openvizsla/ov_ftdi/(threads)

Thread 4 (2015-11-06):

Error in building ov_ftdi

jeffreyantony, 2015-11-06:
I tried to build ov_ftdi. I gave a 'make' in the folder 'ov_ftdi/software/fpga/ov3' and got the below error

Could you let me know how can I remove the below error? I am not sure if I  have an updated 'NetowrkX'.

Is it possible for you to update to the new Migen ?

$ make
python3 build.py build_dir build build_name ov3
Traceback (most recent call last):
  File "build.py", line 24, in <module>
    top = OV3(plat)
  File "/home/robo/tools/ov_ftdi/software/fpga/ov3/ovhw/top.py", line 119, in __init__
    [self.randtest, self.sdram_host_read])
  File "/home/robo/tools/ov_ftdi/software/fpga/ov3/ovhw/cmdproc.py", line 37, in __init__
    self.submodules.fg = CompositeActor(g)
  File "/home/robo/tools/ov_ftdi/software/fpga/migen/migen/flow/network.py", line 222, in __init__
    dfg.elaborate()
  File "/home/robo/tools/ov_ftdi/software/fpga/migen/migen/flow/network.py", line 215, in elaborate
    self._eliminate_subrecords_and_divergences()
  File "/home/robo/tools/ov_ftdi/software/fpga/migen/migen/flow/network.py", line 129, in _eliminate_subrecords_and_divergences
    for (dst_node, dst_endpoint), sources in self._sink_to_sources().items():
  File "/home/robo/tools/ov_ftdi/software/fpga/migen/migen/flow/network.py", line 101, in _sink_to_sources
    for u, v, data in self.edges_iter(data=True):
AttributeError: 'DataFlowGraph' object has no attribute 'edges_iter'
Makefile:18: recipe for target 'build/ov3.bit' failed
make: *** [build/ov3.bit] Error 1

Goddard, 2016-03-17:
I think the main maintainer passed away.  If anything is going to happen it is gonna have to be us.

Thread 6 (2017-10-17):

I'm ordering PCB any one interested?

kopasiak, 2017-10-17:
Hi,

Together with my colleagues we are planing to build couple of OpenVizsla for us. Any one interested in ordering PCBs together or getting a mounted device?

Leave message in this thread or drop me an email at kopasiak90+openvizsla (<stop spam> at) gmail.com

Goddard, 2018-03-10:
I know this is probably kind of late, but still doing it?

wxh0000mm, 2018-11-27:
I plan to make PCB by myself, buy chips for soldering and DIY.

Thread 8 (2018-03-03):

Where's the license?

micolous, 2018-03-03:
Looking over this repository, I cannot find any license for the software.  Please add one!

https://choosealicense.com/no-permission/

Goddard, 2018-03-10:
The guy that made this hardware and software passed away.

micolous, 2018-03-11:
Hmm... this is difficult then.

I happened to borrow some of this hardware to debug some USB issues I'm having.  I'm trying to "finish" the Wireshark module. There's some code in sigrok that implements a state machine that allows transforming USB link-layer into the same sort of USB captures that you get out of Linux usbmon. That would be good enough.

However, in order to incorporate the two together would violate the license of sigrok -- as that is GPL, and OV is "???".

The only way I see around that is to entirely reimplement the host software side of things.  This is difficult for me as there is also little documentation about how the host-device communication works. I don't feel comfortable working from the existing source release when the license is undefined.

Even if I find some other documentation here that would point to a license from the original author, there are also other contributors to the project, and _their_ intent is also unclear.

I could write something up that solves my problems, but I would not be able to release it.

I'm just mindful of getting into too much yak shaving. ;)

Goddard, 2018-03-11:
Well the designs of the hardware are under creative commons.  As for the code, most people deal with instances like that by just having an automated downloader and if a third-party provides the binaries you can even auto-download those and the user clicks the button which results in no infringement on a license.

somehdlguy, 2018-03-11:
Hey all, re license. Everything I wrote (parts of the host python, comms and the FPGA HDL) may be considered to be under 2-clause BSD. I'm speaking with some of the others that wrote large chunks of code (tmbinc, marcan et al) and we'll agree on a license and put a license statement up.

It'll be something open source, just not sure on exactly which one we'll end up with. (probably GPL-2-or-later, or BSD would be my guess)

somehdlguy, 2018-03-11:
Also, I can talk about

tmbinc, 2018-03-11:
For what I wrote:

 - Wireshark plugin is probably derived work, so it'll be GPLv2. I'll add a LICENSE immediately.
 - For any HDL code that I wrote I'm fine with 2-clause BSD. Once we agreed, we'll put a LICENSE file there.

somehdlguy, 2018-03-11:
I spoke to marcan, he's OK with 2-clause BSD for everything he touched. You wrote / extended a bunch of the host side python code as well (I assume you are OK with 2-clause BSD on that?).

In any case, between the 3 of us, we wrote the vast majority of the host-side and device side code. Ben mostly contributed bugfixes to the host-side code, his primary responsibility was the hardware (which as is noted above, he marked CC-BY-SA).

I think we are good to go with 2-clause BSD then, with an exception for the wireshark derived code which would be GPLv2.

tmbinc, 2018-03-11:
Sounds good!

micolous, 2018-03-13:
Thanks for clearing this up!

Closed 2018-03-11.

Thread 9 (2018-05-12):

Hardware for project

tbutton, 2018-05-12:
All versions of Openvizsla out of stock. Could you help please suggest another board for this project. Thank you!

laf0rge, 2018-06-07:
I'm not in the US but would be interested in buying any of the "old" OpenViszla boards.  In fact, I'm even interested in building some more, as needed (I regularly design + build all kinds of electronics).

The big question to me is what happened to the project, given the huge kickstarter success 4 years ago, and the statement from @tmbinc that hardware/gateware is "done".  As a regular wireshark contributor, I'm not so worried about having to improve the visualization side on the host.  Also, these days sigrok has USB trace decoding/displaying capabilities, too.

laf0rge, 2018-06-07:
thanks for your feedback.  I think I would be interested in playing with one of the units for some time in order to see if and how to move it ahead.  Making the hardware available is not a problem for me, we already make available several circuit boards from the @osmocom community and distribute it over the sysmocom webshop, such as the Osmcoom SIMtrace, which is a protocol tracer for SIM cards (or actually any smart cards).

Please note that I'm not primarily interested in *selling* something, but simply in enabling anyone to easily get their hands on a related board if they'd like to play with it.

To me, this project looks a bit like a "hidden gem".  A lot of work was done years ago, several people claim that the it's fundamentally working.  There doesn't appear to be any FOSS / OpenHardware alternative, and for many use cases sniffing FS/HS USB is also still more than sufficient.

It would be great if I could somehow get my hands on a "known working" board first to avoid having to spend time on building a board from scratch and doign board-bringup, testing, etc. on a device that I'm not familiar with yet...

somehdlguy, 2018-06-07:
@laf0rge: I'll follow up with you directly via email or IRC regarding availability of a board for development purposes.

Separately, I'll see whether the tree still builds with current versions of dependencies, and if necessary, fix the build.

cyphunk, 2018-08-20:
@laf0rge I have one from the original kickstarted I'd happily loan you. I know it worked a few years ago.

laf0rge, 2021-05-31:
In case it hasn't been noticed meanwhile, there are two sources for OpenVizsla that have appeared manwhile, see the links in the README.md at https://github.com/openvizsla/ov_ftdi#obtaining-hardware

Closed 2021-05-31.

Thread 10 (2018-07-06):

Migrate FPGA firmware to the latest Migen

matwey, 2018-07-06:
Well, if somebody have a branch with support of the latest Migen, please put a note here.

somehdlguy, 2018-07-06:
I have an in-progress port to the latest migen. It currently generates a bitstream that isn't fully tested yet, and I still need to fix some of the sim tests. I should be able to finish testing it in the next few days at which point  I'll push the branch.

matwey, 2018-07-06:
@somehdlguy really nice to hear that. Do you have write access to this repo?

somehdlguy, 2018-07-06:
I do, and I'll push it here once I have it tested. I'll close this issue at that time so you get a notification.

matwey, 2018-07-06:
Thank you very much.

matwey, 2018-08-04:
What do I do wrong? I use migen and misoc from master.

```
> make
python3 build.py build_dir build build_name ov3
. /opt/Xilinx/14.7/ISE_DS/common/.settings64.sh /opt/Xilinx/14.7/ISE_DS/common
. /opt/Xilinx/14.7/ISE_DS/EDK/.settings64.sh /opt/Xilinx/14.7/ISE_DS/EDK
. /opt/Xilinx/14.7/ISE_DS/PlanAhead/.settings64.sh /opt/Xilinx/14.7/ISE_DS/PlanAhead
. /opt/Xilinx/14.7/ISE_DS/ISE/.settings64.sh /opt/Xilinx/14.7/ISE_DS/ISE
Release 14.7 - xst P.20131013 (lin64)
Copyright (c) 1995-2013 Xilinx, Inc.  All rights reserved.
-->
WARNING:Xst:1583 - You are using an internal switch '-use_new_parser'.

TABLE OF CONTENTS
  1) Synthesis Options Summary
  2) HDL Parsing
  3) HDL Elaboration
  4) HDL Synthesis
       4.1) HDL Synthesis Report
  5) Advanced HDL Synthesis
       5.1) Advanced HDL Synthesis Report
  6) Low Level Synthesis
  7) Partition Report
  8) Design Summary
       8.1) Primitive and Black Box Usage
       8.2) Device utilization summary
       8.3) Partition Resource Summary
       8.4) Timing Report
            8.4.1) Clock Information
            8.4.2) Asynchronous Control Signals Information
            8.4.3) Timing Summary
            8.4.4) Timing Details
            8.4.5) Cross Clock Domains Report

=========================================================================
*                      Synthesis Options Summary                        *
=========================================================================
---- Source Parameters
Input File Name                    : "top.prj"
Input Format                       : MIXED

---- Target Parameters
Output File Name                   : "top.ngc"
Target Device                      : xc6slx9-tqg144-3

---- Source Options
Top Module Name                    : top
Use New Parser                     : yes
Automatic Register Balancing       : yes

---- General Options
Optimization Goal                  : SPEED

=========================================================================

WARNING:Xst:29 - Optimization Effort not specified
=========================================================================

=========================================================================
*                          HDL Parsing                                  *
=========================================================================
Analyzing Verilog file "/home/matwey/lab/ov_ftdi/software/fpga/ov3/build/top.v" into library work
Parsing module <top>.
ERROR:HDLCompiler:1660 - "/home/matwey/lab/ov_ftdi/software/fpga/ov3/build/top.v" Line 4518: Procedural assignment to a non-register overflowinserter_re is not permitted, left-hand side should be reg/integer/time/genvar
ERROR:HDLCompiler:1660 - "/home/matwey/lab/ov_ftdi/software/fpga/ov3/build/top.v" Line 4518: Procedural assignment to a non-register overflowinserter_re is not permitted, left-hand side should be reg/integer/time/genvar
ERROR:HDLCompiler:1660 - "/home/matwey/lab/ov_ftdi/software/fpga/ov3/build/top.v" Line 4881: Procedural assignment to a non-register sdram_sink_ptr_read_re is not permitted, left-hand side should be reg/integer/time/genvar
ERROR:HDLCompiler:1660 - "/home/matwey/lab/ov_ftdi/software/fpga/ov3/build/top.v" Line 4881: Procedural assignment to a non-register sdram_sink_ptr_read_re is not permitted, left-hand side should be reg/integer/time/genvar
ERROR:HDLCompiler:1660 - "/home/matwey/lab/ov_ftdi/software/fpga/ov3/build/top.v" Line 4921: Procedural assignment to a non-register sdram_sink_debug_ctl_re is not permitted, left-hand side should be reg/integer/time/genvar
ERROR:HDLCompiler:1660 - "/home/matwey/lab/ov_ftdi/software/fpga/ov3/build/top.v" Line 4921: Procedural assignment to a non-register sdram_sink_debug_ctl_re is not permitted, left-hand side should be reg/integer/time/genvar
ERROR:HDLCompiler:1660 - "/home/matwey/lab/ov_ftdi/software/fpga/ov3/build/top.v" Line 5063: Procedural assignment to a non-register sdram_sink_ptr_read_re is not permitted, left-hand side should be reg/integer/time/genvar
ERROR:HDLCompiler:1660 - "/home/matwey/lab/ov_ftdi/software/fpga/ov3/build/top.v" Line 5063: Procedural assignment to a non-register sdram_sink_ptr_read_re is not permitted, left-hand side should be reg/integer/time/genvar
ERROR:HDLCompiler:1660 - "/home/matwey/lab/ov_ftdi/software/fpga/ov3/build/top.v" Line 5076: Procedural assignment to a non-register sdram_sink_debug_ctl_re is not permitted, left-hand side should be reg/integer/time/genvar
ERROR:HDLCompiler:1660 - "/home/matwey/lab/ov_ftdi/software/fpga/ov3/build/top.v" Line 5076: Procedural assignment to a non-register sdram_sink_debug_ctl_re is not permitted, left-hand side should be reg/integer/time/genvar
ERROR:HDLCompiler:1660 - "/home/matwey/lab/ov_ftdi/software/fpga/ov3/build/top.v" Line 5107: Procedural assignment to a non-register overflowinserter_re is not permitted, left-hand side should be reg/integer/time/genvar
ERROR:HDLCompiler:1660 - "/home/matwey/lab/ov_ftdi/software/fpga/ov3/build/top.v" Line 5107: Procedural assignment to a non-register overflowinserter_re is not permitted, left-hand side should be reg/integer/time/genvar
ERROR:HDLCompiler:1660 - "/home/matwey/lab/ov_ftdi/software/fpga/ov3/build/top.v" Line 5232: Procedural assignment to a non-register data_out_source_stb is not permitted, left-hand side should be reg/integer/time/genvar
ERROR:HDLCompiler:1660 - "/home/matwey/lab/ov_ftdi/software/fpga/ov3/build/top.v" Line 5232: Procedural assignment to a non-register data_out_source_stb is not permitted, left-hand side should be reg/integer/time/genvar
ERROR:HDLCompiler:1660 - "/home/matwey/lab/ov_ftdi/software/fpga/ov3/build/top.v" Line 5234: Procedural assignment to a non-register data_out_source_payload_d is not permitted, left-hand side should be reg/integer/time/genvar
ERROR:HDLCompiler:1660 - "/home/matwey/lab/ov_ftdi/software/fpga/ov3/build/top.v" Line 5234: Procedural assignment to a non-register data_out_source_payload_d is not permitted, left-hand side should be reg/integer/time/genvar
ERROR:HDLCompiler:1660 - "/home/matwey/lab/ov_ftdi/software/fpga/ov3/build/top.v" Line 5235: Procedural assignment to a non-register data_out_source_payload_rxcmd is not permitted, left-hand side should be reg/integer/time/genvar
ERROR:HDLCompiler:1660 - "/home/matwey/lab/ov_ftdi/software/fpga/ov3/build/top.v" Line 5235: Procedural assignment to a non-register data_out_source_payload_rxcmd is not permitted, left-hand side should be reg/integer/time/genvar
ERROR:HDLCompiler:1660 - "/home/matwey/lab/ov_ftdi/software/fpga/ov3/build/top.v" Line 5239: Procedural assignment to a non-register data_out_source_payload_d is not permitted, left-hand side should be reg/integer/time/genvar
Sorry, too many errors..
-->
```

matwey, 2018-08-04:
There is no branch `new_migen` in `tmbinc/ov_ftdi`. I've tried `new_migen` from `openvizsla/ov_ftdi`.

matwey, 2018-08-04:
I am sorry, I've found correct branch. Thank you.

Thread 11 (2018-07-11):

Licensing and selling

matwiszynmarek, 2018-07-11:
Good morning,
I have been doing a research about this type of products and I have got a few questions.
1. What are the certifications for this product (I mean EMC, RCC, CE etc.)?
2. What is the license for software and hardware?
3. Is it possible to sell OpenVizsla made by my own production?

I'll be very thankful if you respond me.

Yours sincerely
Marek

somehdlguy, 2018-07-28:
1. There are no certs that we are aware of. Any certs that were acquired as part of the kickstarter run are unknown to us (and bushing, who would have known, passed away).
Before you sell anything, you'll need to figure out what certs are required for the jurisdictions you plan to sell to, then acquire said certs.
2. The license varies depending on what part of the repo. Some files are under CC-like terms, some under GPL, some under BSD. Check the license files in the repo.
3. Sure, why not. Just follow the licenses and release any modifications as is required. (though, we'd appreciate patches for the parts of the code under BSD).

I'd suggest that if you are going to production, you consider updating to a newer FPGA, and review the BOM for EOL components. Of course, you would then need to re-debug and requalify the design.

Closed 2018-07-28.

Thread 13 (2018-08-05):

SDRAM data trapping

matwey, 2018-08-05:
I am working on pure-C implementation for OpenVizsla host software: https://github.com/matwey/libopenvizsla
I've faced the following issue with FPGA firmware last summer.
I have been not able to make FPGA reliable restart sniffed data transmission.

The issue itself is the following.
The protocol has two encapsulation levels.
The upper level is packets come from SDRAM buffering module.
The packets consists of `0x0D` magic header, `length` byte, and the `data`.
On practice this packets are of the same length.
The nested data is a stream consisted of packets from captured data.
They are consisted of `0xA0` magic header, `length` and USB `data`.
This packets are not aligned with each other.
One `0x0D`-packet may consisted many `0xA0`-packets, and `0xA0`-packet may be split between two consecutive `0x0D`-packets.

When I stop capturing and streaming and start it again then the first data byte of the first `0x0D`-packet is not `0xA0` which it should be.
This is an issue because there is no other reliable way to sync `0xA0`-packet stream. We cannot just scan for first `0xA0` because `0xA0` byte may be consisted inside `data` itself (compare with SLIP protocol).

My stop sequence is the following:

 * write `0` to `SDRAM_HOST_READ_GO` (`0xC28`)

 * write `0` to `SDRAM_SINK_GO` (`0xE11`)

 * write `0` to `CSTREAM_CFG` (`0x800`)

My start sequence is the following (given I assured that the stream is stopped):

 * write 32-bit `0` to `SDRAM_SINK_RING_BASE` (`0xE09`)

 * write 32-bit `0x01000000` to `SDRAM_SINK_RING_END` (`0xE0D`)

 * write 32-bit `0` to `SDRAM_HOST_READ_RING_BASE` (`0xC1C`)

 * write 32-bit `0x01000000` to `SDRAM_HOST_READ_RING_END` (`0xC20`)

 * write `0` to `SDRAM_SINK_PTR_READ` (`0xE00`)

 * write `1` to `CSTREAM_CFG` (`0x800`)

 * write `1` to `SDRAM_SINK_GO` (`0xE11`)

 * write `1` to `SDRAM_HOST_READ_GO` (`0xC28`)

I've tried to add `Reset` for `sdram_fifo` in `SDRAM_Sink` and `SDRAM_Host_Read` to reset fifoes on `SDRAM_SINK_GO`/`SDRAM_HOST_READ_GO` switch but this didn't help.

tmbinc, 2018-08-05:
First, remember how the SDRAM buffering works: There's the SDRAM_SINK
which sinks 8-bit data from the cstream (aka "Whacker"), and writes it
into SDRAM.

Then there's the SRAM_Host_Read, which reads data from SDRAM, packetizes
it to host_burst_length (=16 * 2bytes), and sends those over the
"CmdProc", aka. the thing that muxes together the different data sources
for the return (FTDI) channel.

SDRAM_Sink and SDRAM_Host_Read know each other's read/write pointers so
that we have flow control.

cstream (whacker's producer) receives data from ULPI (timestamp'ed
d/is_start/is_end/is_err/isovr) and formats it into the A0 <flags>
<size> <data> (which SDRAM_Sink writes into memory).

That means that once these packets arrive in SDRAM, there's no packet
boundary anymore; SDRAM_Host_Read doesn't care what the data is, it only
knows about the write pointer and will stream everything to that point.

Now, note that SDRAM_Sink will write partial packets, but at a 2 byte
granularity. However they will be collected on the input side, so no
data should be lost if you toggle GO, _assuming_ you still read out any
data.

sdram_host_sink on the other hand only sends full-sized packets to the
host (as you observed). The current rptr resets if you toggle go, and at
that point you almost certainly lost data.

So I'd think (but I haven't verified) that the correct way to pause
transfers would be the opposite order:

1. Disable streaming via CSTREAM_CFG. This halts receiving incoming ULPI
data, but should write out the rest of the current A0... packet.

2. Disable writing data to SDRAM via SDRAM_SINK_GO.

Once you read all data, you can do this:

3. Disable streaming data from SDRAM to HOST.

However note that there's currently no "flush" action - the last packet
will most likely not fully align to the 32 byte burst size so you'll
miss the last packet. Additionally one byte could be stuck in the
SDRAM_SINK that you can't un-stuck. (Perhaps it would be wise to make
the packets always even-length size...)

I'm not fully clear on your motivation to stop streaming, but if it's
just to ignore USB data for a while, to avoid the issue with the last
packet, I'd propose that you instead keep the SDRAM data streaming
enabled, and only pause using CSTREAM (i.e. only clear CSTREAM_CFG[0],
nothing else). You may still get a partial CSTREAM packet, but you would
get the rest of the packet when you re-enable it (and you could then
drop it).

For starting, I would also advise to turn the data flow on first
(SDRAM_HOST_Read+SDRAM_Sink, then CSTREAM) because otherwise you may get
an overflow in CSTREAM if you're not fast enough in this sequence.

In summary, I think the following additions would be "nice to have" :

1. CSTREAM should only produce even-length packets.
2. CSTREAM should indicate when it's done writing the last packet.
2a. CSTREAM could write a special pattern that indicates it was asked to
stop.
3. SDRAM_Sink should indicate when a single byte is stuck when ~go
(though this "shouldn't happen")
4. SDRAM_Host_Read should send a partial packet when go is deasserted,
and not wait for the full burst.
5. SDRAM_Host_Read should indicate when it is done sending all data.
6. We should have a global reset (as opposed to "go"); the intention
would be that deasserting "go" doesn't lose data (unless there's a fifo
overrun), but asserting "reset" would.

Felix

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

matwey, 2018-08-19:
Hello,

The motivation is simple. Any application can crash unexpectedly, so we cannot guarantee graceful exit. So the most reliable on-start behavior for us is to force stop streaming, and reinit all the things as they expected to be (full reset), and the start streaming from the scratch.

I've followed your advice and reordered starting procedure, but there is still no success. Even `CSTREAM` and `SINK` are OFF (and `SDRAM` pointers are reset to `0`), then the unexpected data are transmitted to host after I trigger `SDRAM_HOST_READ`.

Could you please also review the following:
https://github.com/matwey/ov_ftdi/commit/0ffe58f453fe70e08786f64027f241f3a6c0c96c
Does it makes sense?

matwey, 2018-08-19:
The most reliable setup is the following:
```
        // dev.regs.SDRAM_SINK_GO.wr(1)
        // dev.regs.SDRAM_HOST_READ_GO.wr(1)
        // dev.regs.CSTREAM_CFG.wr(1)
```
Using https://github.com/matwey/ov_ftdi/commit/0ffe58f453fe70e08786f64027f241f3a6c0c96c

matwey, 2018-08-19:
I still see that there is extra byte between `d0` and `a0`:

```
        0x0000:  3260 d01f 27a0 1000 0000 7df6 69a0 0000
        0x0010:  0300 3d43 7169 8498 a000 0001 00a5 4971
        0x0020:  5aa0 0000 0300 6596 7869 8498 a000 0001
        0x0030:  00cd 9c78 5aa0 0000 0300 8de9 7f69 8498
        0x0040:  a000 0001
```

Here `1f` is size byte, and then `a0` should follows in theory.

matwey, 2018-08-19:
Now I see that `self.fifo_fsm` from `SDRAM_sink` needs to be force reset to `READ_LOW` at every sink restart. Otherwise, it may cache the last odd byte from previous run.

somehdlguy, 2018-08-19:
Patches to fix this kind of thing are welcome! (I haven't been able to find my board to do anything that requires HW-in-the-loop testing).

Thread 17 (2018-09-11):

Output information from OV

ar0mat, 2018-09-11:
Hello everyone. I've been testing an OpenVizsla v3.2 device and I have a couple of problems. I'm trying to analyze a pendrive [https://stat-s9.ms-online.pl/media/cache/gallery/rc/b5o50r65/bdk/78/786367_0.jpg](url) and USB-UART converter.

I'm using software from the `master` branch. All of the tests are ok so the board is assembled correctly (I think)

But when I do sniffing, I receive such information, but nothing stems from it.

```
[        ]  60.145390 d=  0.000003 [ 69.4 + 89.817] [  3] IN   : 12.1
[        ]  60.145393 d=  0.000003 [ 69.4 + 92.467] [  3] IN   : 12.1
[        ]  60.145395 d=  0.000003 [ 69.4 + 95.117] [  3] IN   : 12.1
[        ]  60.145405 d=  0.000009 [ 69.4 +104.483] [  1] ACK
[        ]  60.145405 d=  0.000000 [ 69.4 +104.967] [  3] IN   : 12.1
[        ]  60.145408 d=  0.000003 [ 69.4 +107.617] [  3] IN   : 12.1
[        ]  60.145410 d=  0.000003 [ 69.4 +110.267] [  3] IN   : 12.1
[        ]  60.145426 d=  0.000015 [ 69.5 +  0.583] [  3] IN   : 12.1
[        ]  60.145431 d=  0.000005 [ 69.5 +  5.900] [  3] IN   : 12.1
[        ]  60.145434 d=  0.000003 [ 69.5 +  8.550] [  3] IN   : 12.1
[        ]  60.145436 d=  0.000003 [ 69.5 + 11.200] [  3] IN   : 12.1
```
I expected the output to be like in the manual for `HS sniffing` for a USB flash drive
```
$ ./ovctl.py -p ov3.fwpkg sniff hs
[   F    ]   0.267814 d=  0.267814 [   .0 +267814.250] [  0]
[        ]   1.123487 d=  0.855673 [255.7 +  0.600] [  3] IN   : 2.1
[        ]   1.123488 d=  0.000001 [255.7 +  1.250] [  1] ACK
[        ]   1.224924 d=  0.101436 [101.2 + 54.550] [  3] SETUP: 2.0
[        ]   1.224924 d=  0.000000 [101.2 + 54.967] [ 11] DATA0: a3 00 00 00 02 00 04 00 f6 e1
[        ]   1.224927 d=  0.000003 [101.2 + 57.933] [  3] IN   : 2.0
[        ]   1.224928 d=  0.000001 [101.2 + 58.633] [  1] ACK
[        ]   1.224930 d=  0.000002 [101.2 + 60.800] [  3] OUT  : 2.0
[        ]   1.224930 d=  0.000000 [101.2 + 61.217] [  3] DATA1: 00 00
[        ]   1.225175 d=  0.000245 [101.4 + 55.900] [  3] SETUP: 2.0
[        ]   1.225175 d=  0.000000 [101.4 + 56.317] [ 11] DATA0: 23 01 14 00 02 00 00 00 ef 95
...
# 0000000: 2203 4400 6100 7400 6100 5400 7200 6100  ".D.a.t.a.T.r.a.
# 0000010: 7600 6500 6c00 6500 7200 2000 3200 2e00  v.e.l.e.r. .2...
# 0000020: 3000 ce3a                                0..:
[        ]   1.242314 d=  0.000000 [118.5 + 68.383] [ 37] DATA1: 22 03 44 00 61 00 74 00 61 00 54 00 72 00 61 00 76 00 65 00 6c 00 65 00 72 00 20 00 32 00 2e 00 30 00 ce 3a
```
When I use a card reader, I obtain
```
Unmatched byte a5 - discarding
Unmatched byte 49 - discarding
Unmatched byte 64 - discarding
0 / 16777216 (0.00 % utilization) 0 kB | 0 overflow, 00c3537c total | R0000012c W0000012c
0 overflow, 02c433e5 total
0 / 16777216 (0.00 % utilization) 0 kB | 0 overflow, 09a1e6e3 total | R0000012c W0000012c
0 overflow, 0ba2608a total
0 / 16777216 (0.00 % utilization) 0 kB | 0 overflow, 12801e45 total | R0000012c W0000012c
```
Or maybe I don't how it means to be used. Can anyone explain it?

marcan, 2018-09-11:
Your first log looks fine. That's just idle traffic on the bus (the host polling device 12.1, which is probably an input device - the sniffer will see all downstream traffic on the bus, not just the traffic intended for the device behind it). Did you actually do something to the drive, like read/write some data or reconnect it, after starting to sniff?

In order to avoid noise from other devices on the bus, I would recommend connecting the sniffer's sniff-side upstream port to a USB controller with no other devices connected, though that is not a requirement.

marekmatw, 2018-09-11:
I do no operations when sniffing. There is just one file with an `*.txt` extension on it.

I also have no devices connected. Just the OV. Maybe it is like that becaues I use a drive USB3.0

marcan, 2018-09-11:
If you do nothing to the drive while sniffing then of course you will get no traffic. Try doing something?

OpenVizsla does not support USB3.0, but any SuperSpeed devices should fall back to High Speed mode when connected through OV.

marekmatw, 2018-09-11:
I noticed that sniffing stops in one point. For instance

```
PERR: 0002 (Overflow)
[      O ]  11.881343 d=  0.000000 [ 87   +128.433] [196] DATA1: 25 e5 13 f3 ae 2e 88 ba 87 b6 52 df 5f df 56 70 23 cd 57 b9 8a 68 e6 f2 1d 35 0d b5 c6 e0 59 4e 65 de d1 af 04 84 c9 e5 16 a0 86 0e a5 12 ff a1 4b ca 7a 92 7d db eb f6 5c b1 15 92 52 7d e8 2a 5c 05 b5 7c 99 ab a5 50 a7 dc 3e b6 85 eb 94 f2 00 83 e2 ed 97 e1 b9 b7 53 1f 6a 0e 02 80 08 30 1d d7 0f c1 77 47 91 03 05 05 5e fe 80 c7 6a 85 45 82 f9 2b f5 56 e1 4d ae 5a e9 4f 22 e0 58 f7 52 b0 9f 3f 3e 7e b8 4e f1 52 4e b7 88 43 ac 13 54 d6 24 48 43 d0 09 2f a0 78 2f 1e 3e 8f 2e f6 34 f8 bc 49 0d d2 02 97 77 b8 8e fa 46 da 3c b1 8c 82 02 d5 a9 b3 e4 67 3b 2e c7 61 4b e0 95 0c d7 64 29	Unexpected ERR CRC
[        ]  11.881347 d=  0.000004 [ 87   +131.967] [ 53] Err - bad PID of 0f
[        ]  11.881348 d=  0.000001 [ 87   +133.117] [  1] ACK
[        ]  11.881350 d=  0.000003 [ 87   +135.883] [467] Err - bad PID of 0c
[        ]  11.881359 d=  0.000008 [ 87   +143.967] [  1] ACK
[        ]  11.881359 d=  0.000001 [ 87   +144.733] [  3] IN   : 31.1
[        ]  11.881369 d=  0.000009 [ 87   +154.200] [  1] ACK
[        ]  11.881369 d=  0.000000 [ 87   +154.683] [  3] OUT  : 33.2
```

marcan, 2018-09-11:
Overflow suggests the OV can't keep up with the throughput on the bus. If you have it on the same controller as the target device, you should move it to a different controller to maximize your available bandwidth. Also keep in mind you cannot sniff a bus that is fully utilized forever, since the available sniffing throughput is less since it has to itself go over USB with overhead.

ar0mat, 2018-10-09:
Everything works. Thank you @marcan for your help and time.

Closed 2018-10-09.

Thread 19 (2018-10-09):

EEPROM programming issue

ar0mat, 2018-10-09:
Hello!
I'm trying to program the EEPROM. I have been stuck in this step.
```
$ sudo python3 ovctl.py -p ov3.fwpkg eep-program 10000
FPGA not loaded, forcing reload
FPGA: Bitstream timestamp 2014/11/10 16:31:07
FPGA: sending configuration bitstream
FPGA: CRC OK
FPGA: configured
00: ffff ffff ffff ffff ffff ffff ffff ffff ffff ffff ffff ffff ffff ffff ffff ffff
10: ffff ffff ffff ffff ffff ffff ffff ffff ffff ffff ffff ffff ffff ffff ffff ffff
20: ffff ffff ffff ffff ffff ffff ffff ffff ffff ffff ffff ffff ffff ffff ffff ffff
30: ffff ffff ffff ffff ffff ffff ffff ffff ffff ffff ffff ffff ffff ffff ffff(ffff)
EEPROM: Device blank or checksum incorrect
EEPROM: Generated serial OV010000
```
After the assembly process, I noticed that EEPROM had been soldered other way around. I have that chip replaced by a new one, but it still does not work.

FTDI and Y2 oscillator are soldered correctly.

marcan, 2018-10-09:
What does eep-program say after you fixed the EEPROM? Does it complain or do you get a successful `EEPROM: Programmed` message?

If programming fails then you might still have a hardware issue. Check for short and open pins.

ar0mat, 2018-11-21:
Here is what I receive after fixing the EEPROM:
```
$ sudo python3 ovctl.py -p ov3.fwpkg eep-program 1421312
00: ffff ffff ffff ffff ffff ffff ffff ffff ffff ffff ffff ffff ffff ffff ffff ffff
10: ffff ffff ffff ffff ffff ffff ffff ffff ffff ffff ffff ffff ffff ffff ffff ffff
20: ffff ffff ffff ffff ffff ffff ffff ffff ffff ffff ffff ffff ffff ffff ffff ffff
30: ffff ffff ffff ffff ffff ffff ffff ffff ffff ffff ffff ffff ffff ffff ffff(ffff)
EEPROM: Device blank or checksum incorrect
EEPROM: Generated serial OV142131
```

Basically, nothing has changed. Unplugging hasn't solved the problem. I've checked the connections. There is no fault in assembly. When I enumerate devices with `lsusb` command, I receive
```
$ lsusb
Bus 002 Device 002: ID 8087:0024 Intel Corp. Integrated Rate Matching Hub
Bus 002 Device 001: ID 1d6b:0002 Linux Foundation 2.0 root hub
Bus 001 Device 005: ID 046d:c31c Logitech, Inc. Keyboard K120
Bus 001 Device 004: ID 046d:c077 Logitech, Inc. M105 Optical Mouse
Bus 001 Device 011: ID 0403:6010 Future Technology Devices International, Ltd FT2232C Dual USB-UART/FIFO IC
Bus 001 Device 002: ID 8087:0024 Intel Corp. Integrated Rate Matching Hub
Bus 001 Device 001: ID 1d6b:0002 Linux Foundation 2.0 root hub
Bus 004 Device 001: ID 1d6b:0003 Linux Foundation 3.0 root hub
Bus 003 Device 001: ID 1d6b:0002 Linux Foundation 2.0 root hub
```
so FT2232H is recognizable.

I'm curious what are these lines responsible for:
```
00: ffff ffff ffff ffff ffff ffff ffff ffff ffff ffff ffff ffff ffff ffff ffff ffff
10: ffff ffff ffff ffff ffff ffff ffff ffff ffff ffff ffff ffff ffff ffff ffff ffff
20: ffff ffff ffff ffff ffff ffff ffff ffff ffff ffff ffff ffff ffff ffff ffff ffff
30: ffff ffff ffff ffff ffff ffff ffff ffff ffff ffff ffff ffff ffff ffff ffff(ffff)
```

marcan, 2018-11-21:
If you don't get an "EEPROM: Programmed" message on `eep-program` then programming is failing. Check your FTDI and EEPROM pins for shorts and opens. If the EEPROM has been replaced then maybe something on the FTDI is broken, though honestly I would be surprised if placing the EEPROM on backwards would damage the FTDI.

Thread 22 (2018-12-04):

Burn the firmware step file

wxh0000mm, 2018-12-04:
Hello:
OV3 folder has been built. I have not found out how to burn the built firmware into the chip. Could you please provide me with the corresponding files?

wxh0000mm, 2018-12-04:
First contact, there are many places do not understand, please give me guidance.thank you

somehdlguy, 2018-12-04:
The FPGA bitstream isn't burnt into the chip or board. It is loaded on-demand when you use `ovctl.py` to talk to the board.
The only programmable part of the board is the FTDI EEPROM. You shouldn't need to do this with a board you got from the kickstarter! It should already be programmed. If you have a hand-built board, or if you somehow erased the EEPROM, you can reprogram the FPGA with:

- `ovctl.py eep-erase`
- `ovctl.py eep-program SERIALNO`

wxh0000mm, 2018-12-05:
Unmatched byte 10 - discarding
Unmatched byte 08 - discarding
Unmatched byte 10 - discarding
Unmatched byte 08 - discarding
Unmatched byte 10 - discarding
Unmatched byte 18 - discarding
Unmatched byte 10 - discarding
Unmatched byte 18 - discarding
Unmatched byte 10 - discarding
Unmatched byte 18 - discarding
Unmatched byte 10 - discarding
Unmatched byte 18 - discarding
Unmatched byte 10 - discarding
Unmatched byte 00 - discarding
Unmatched byte 10 - discarding
Unmatched byte 00 - discarding
Unmatched byte 10 - discarding
Unmatched byte 00 - discarding
Unmatched byte 10 - discarding
Unmatched byte 00 - discarding
0 / 16777216 (0.00 % utilization) 144 kB | 0 overflow, 4e4bc6e9 total | R0002402e W0002402e
0 overflow, 52454720 total
Unmatched byte 10 - discarding
Unmatched byte 08 - discarding
Unmatched byte 10 - discarding
Unmatched byte 18 - discarding
Unmatched byte 10 - discarding
Unmatched byte 18 - discarding
Unmatched byte 10 - discarding
Unmatched byte 18 - discarding
Unmatched byte 10 - discarding
Unmatched byte 18 - discarding
Unmatched byte 10 - discarding
Unmatched byte 00 - discarding
Unmatched byte 10 - discarding
Unmatched byte 00 - discarding
Unmatched byte 10 - discarding
Unmatched byte 00 - discarding
Unmatched byte 10 - discarding
Unmatched byte 00 - discarding

hello
I use sudo. / ovctl.py-p ov3wpkg sniffing ls command and the information is exposed like the above. Why?

wxh0000mm, 2018-12-05:
@somehdlguy
king@king-virtual-machine:~/桌面/ov_ftdi/software/host$ sudo ./ovctl.py eep-program serialno
usage: ovctl.py eep-program [-h] serialno
ovctl.py eep-program: error: argument serialno: invalid int value: 'serialno'

My is a manual circuit board, can you complete the following two commands?
Ovctl. Py eep - erase
Ovctl. Py eep - program SERIALNO

Closed 2018-12-05.

Thread 31 (2019-08-14):

Feature request: Filter SOF and/or NAKed transactions

desowin, 2019-08-14:
When debugging USB issues in embedded devices, the importance of very low-level details (SOF and NAKs) lowers as the USB stack implementation improves. Once the low-level issues are solved, user focus shifts more into higher protocol layers. This is where Wireshark dissection engine is invaluable. Unfortunately the captures are growing very rapidly and thus the dissection is taking a lot of memory. For example, the capture attached to Wireshark bugzilla  https://bugs.wireshark.org/bugzilla/show_bug.cgi?id=15908#c6 that contains data captured in less than 12 seconds contains over 1 million packets which require 18 MiB to store in pcap file. The same capture, but on the OS USB URB level (capture contains the payload with very little capture metadata) is merely 9 KiB. The captures are quickly growing to a point where Wireshark dissection engine starts slowing down significantly.

The solution to the capture files growing a lot is to make it possible to filter the low-level data that are of little interest to the user. In my opinion it would be best to implement such filtering in the FPGA gateware itself. The filtering would have a really big impact on reducing the analysis computer CPU uage. Of course, the filtering must be configurable by the user as issues like https://github.com/ARMmbed/mbed-os/pull/11103 are not possible to be detected when the "filter NAKed transactions" option is enabled.

Besides the actual filtering, we would need some time synchronization mechanism to indicate the 24-bit clock counter overflows when the SOFs are filtered, so the host software can track the realtive time with the accuracy of the 60 MHz clock.

somehdlguy, 2019-08-14:
This partly gets into "what OV is intended for vs what it isn't intended for". We originally built it for debugging these very low level issues, for which there previously was no open-source tools. It can certainly be extended for other use cases, but we didn't design the gateware with them in mind.

That said, I this is relatively straightforward to do, but would require changing the initialization process to add a filter setup step. The simplest mechanism would be to add a 16 bit vector that enables or disables capturing that PID.

For counter tracking, I'll think about it. The most straightfoward way would be to extend the timestamp field - but that would increase the capture bandwidth for small packet captures. Another alternative would be to stuff a frame on roll-over if no frame had been sent (~4hz).

I think the technically best solution would be to send an extended timestamp field on any that has a 24bit counter rollover from a previous packet. This has the same downsides as stuffed roll-over frames, but doesn't require a constant stream of information to the host.

This of course changes the packet/wire format (which takes us to the discussion in  #30  ).

desowin, 2019-08-15:
> That said, I this is relatively straightforward to do, but would require changing the initialization process to add a filter setup step. The simplest mechanism would be to add a 16 bit vector that enables or disables capturing that PID.

Such simple solution could only work for SOFs. To effectively filter NAKed transactions a state machine is needed. Basically it is needed to recognize OUT/DATA/NAK or IN/NAK or PING/NAK and filter all these packets if they end in NAK (only if they are not directly after SPLIT packet).

However, a special care needs to be taken regarding the SPLIT transactions, as the simple recognition is not going to work correctly. I think that the NAK filtering of SPLIT transactions can be explicitly omitted - as doing so properly requires quite some memory: the minimal sequence for SPLITed NAK is SPLIT start/IN/ACK/*anything*/SPLIT complete/IN/NAK. The worst is that the
*anything* can be either no transactions or as many as the host wishes. To effectively filter it, everything from SPLIT start up to the last NAK, excluding the *anything* would have to be removed from the trace. The simpliest way to filter SPLIT transactions, is to not generate them in first place, which is rather easy (sniff directly at the end full/low-speed device connection and not through a high speed hub)

somehdlguy, 2019-08-15:
Thanks for the refresher on that. Now I remember why I didn't implement it originally. Its been a few years since I worked with USB at that level, and the details aren't in my working memory anymore.

Would you consider writing up a design document for that state machine filter? Just states, transitions, and decisions on whether the packet should be discarded or forwarded? We could probably simulate that SM in python on existing captures to verify that it works, then I could write some RTL to make it work at wire-speed.

The gateware already has support for filters + discarding packets; we just need the filter itself.

desowin, 2019-08-16:
The "filter NAKed transactions" state machine has 5 states (stDEFAULT, stSPLIT, stIN, stOUT, stOUTDATA) and requires queue that can hold up to two packets (and their respective FPGA clock timestamps). The design explicitly forwards all SPLIT transactions (even if they contain NAKed transaction) as filtering SPLIT transactions requires quite some memory and ability to deliver packets out of order to the analysis software. The "filter NAKed transactions" state machine starts in state stDEFAULT. In order to work properly all packets must enter the state machine (includes SOFs even if the "filter SOF" is enabled).

The state transitions are described in a table below. Table entries are sorted by current state. The PID value "other" denotes all PID values (including PID byte value where the negated form do not match due to transmission error) that do not have explicitly mentioned action originating from given state.

| Current State | PID | Next State | Actions |
| --- | --- | --- | --- |
| stDEFAULT | SPLIT | stSPLIT | forward packet |
| stDEFAULT | IN | stIN | queue packet |
| stDEFAULT | OUT | stOUT | queue packet |
| stDEFAULT | other | stDEFAULT | forward packet |
| stSPLIT | * | stDEFAULT | forward packet |
| stIN | IN | stIN | forward queued packets; queue packet |
| stIN | OUT | stOUT | forward queued packets; queue packet |
| stIN | SPLIT | stSPLIT | forward queued packets; forward packet |
| stIN | NAK | stDEFAULT | discard queued packets; discard packet |
| stIN | other | stDEFAULT | forward queued packets; forward packet |
| stOUT | IN | stIN | forward queued packets; queue packet |
| stOUT | OUT | stOUT | forward queued packets; queue packet |
| stOUT | SPLIT | stSPLIT | forward queued packets; forward packet |
| stOUT | DATA0 | stOUTDATA | queue packet |
| stOUT | DATA1 | stOUTDATA | queue packet |
| stOUT | other | stDEFAULT | forward queued packets; forward packet |
| stOUTDATA | IN | stIN | forward queued packets; queue packet |
| stOUTDATA | OUT | stOUT | forward queued packets; queue packet |
| stOUTDATA | SPLIT | stSPLIT | forward queued packets; forward packet |
| stOUTDATA | NAK | stDEFAULT | discard queued packets; discard packet |
| stOUTDATA | other | stDEFAULT | forward queued packets; forward packet |

The "filter SOF" should operate on packets forwarded by the "filter NAKed transactions" state machine. "filter SOF" forwards are packets whose PID is not SOF.

davidcarne, 2019-08-16:
This is excellent, thank you. I'll look into implementing it. The "dual packet queue" will probably end up being hybridized with the "packet whacker" code since we already have a mechanism for holding data while we think about what to do with it.

As I'm unfortunately without a OV at the moment, would you be able to grab some packet captures (including NAK'ed + SPLIT transactions) that I can use to simulate and debug the filter? Otherwise, I can look into implementing this once I have hardware again.

somehdlguy, 2019-08-16:
This is excellent, thank you. I'll look into implementing  it. The "dual packet queue" will probably end up being hybridized with  the "packet whacker" code since we already have a mechanism for holding  data while we think about what to do with it. As I'm unfortunately without a OV at the moment, would you be able to  grab some packet captures (including NAK'ed + SPLIT transactions) that I  can use to simulate and debug the filter? Otherwise, I can look into  implementing this once I have hardware again.

desowin, 2019-08-16:
In what format would you like the captures?

somehdlguy, 2019-08-16:
I believe PCAP should have everything I need.

desowin, 2019-08-16:
> I believe PCAP should have everything I need.

The https://bugs.wireshark.org/bugzilla/attachment.cgi?id=17250 contains blackmagicprobe-via-hs-hub-usbll.pcap that was generated using OpenVizsla - it contains NAKed and SPLIT transactions. This pcap file uses the LINKTYPE_USB_2_0, which does not contain the OpenVizsla flags. Each pcap packet starts with USB PID. The file can be viewed in latest Wireshark automated builds (only the raw packets, transfer reassembly is not implemented yet).

desowin, 2019-08-17:
I have completely forgot about the PING. I have just updated the state machine transitions to handle PING.

desowin, 2019-10-19:
I have implemented the NAK and SOF filter in C in https://github.com/matwey/libopenvizsla/pull/10/commits/6485454567b76d361506de0004ce8ea30270be39

norbertthiel, 2020-07-07:
I am wondering if there was any progress on applying such a filer on the gateware?

> The gateware already has support for filters + discarding packets; we just need the filter itself.

I saw that in the code and wanted to start implementing a simple "SOF" filter first - then found that "test_producer.py" is broken due to usage of SimActor etc.
Just asking if anyone has already done that work?

Otherwise I am going to try myself

desowin, 2020-07-24:
> The state transitions are described in a table below. Table entries are sorted by current state. The PID value "other" denotes all PID values (including PID byte value where the negated form do not match due to transmission error) that do not have explicitly mentioned action originating from given state.

The easiest way to encounter the "other" PID value is using device that implements Link Power Management. Link Power Management uses PID 0xF0, followed by SubPID 0xC3 (this SubPID uses different CRC scheme than DATA0). According to USB 2.0 Link Power Management Addendum the Link Power Management transactions cannot be NAKed. There is no need to specifically handle them, because the default state handles it nicely.

laf0rge, 2021-03-11:
sorry for the very late follow-up: I think the easiest way for now would be to do the filtering on the host PC side, between receiving the low-level-traces from the ov_ftdi and writing the pcap (or whatever format) files.  That's easy to develop, and should be muhc quicker than changing the gateware in the FPGA.

desowin, 2021-03-12:
> sorry for the very late follow-up: I think the easiest way for now would be to do the filtering on the host PC side, between receiving the low-level-traces from the ov_ftdi and writing the pcap (or whatever format) files. That's easy to develop, and should be muhc quicker than changing the gateware in the FPGA.

This describes exactly what is implemented in https://github.com/matwey/libopenvizsla/commit/db4578e43bb9b7f5030bbd19293a4787ea4134c4

laf0rge, 2021-03-12:
> This describes exactly what is implemented in [matwey/libopenvizsla@db4578e](https://github.com/matwey/libopenvizsla/commit/db4578e43bb9b7f5030bbd19293a4787ea4134c4)

Oh great.  I wasn't even aware that there is a C language library now (excellent news!).

I would like to invite @matwey to migrate  the repository within the openvizsla github project to give it more visibility. I think it's best if all openvizsla related code resided here.

matwey, 2021-03-12:
@laf0rge I've never migrated the repos, so I have no idea how to proceed :-) Will I still have an access to the repo?

laf0rge, 2021-03-12:
> @laf0rge I've never migrated the repos, so I have no idea how to proceed :-) Will I still have an access to the repo?

You would of course get the same permissions (assigned by the openvizsla github "organization") as in your own "user" domain.  The process is described at https://docs.github.com/en/github/administering-a-repository/transferring-a-repository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

Once again, just a suggestion. Not trying to take anything away from you. I just thought it's good to have all OV related  code in one place, next to each other.

matwey, 2021-03-12:
I am fine with migration, just curious how many things are going to break. Probably all CI stuff and deploy keys for windows builds?

Thread 32 (2019-08-14):

Err - bad PID of 0f

attie, 2019-08-14:
I've just received my OpenVisla v3.2 from sysmocom (Thanks!), and I'm seeing some unexpected output.

With no downstream device connected (J1 and J2 are connected to the same host, J3 is not connected to anything) I see the following...

```
$ ./software/host/ovctl.py sniff fs
FPGA not loaded, forcing reload
FPGA: Bitstream timestamp 2014/11/10 16:31:07
FPGA: sending configuration bitstream
FPGA: CRC OK
FPGA: configured
[   F    ]   0.178034 d=  0.178034 [   .0 +178033.667] [  0]
PERR: 0001 (Error)
[       E]   0.229603 d=  0.051569 [   .0 +229603.150] [  0]
[        ]   0.229604 d=  0.000001 [   .0 +229604.083] [  1] Err - bad PID of 0f
PERR: 0001 (Error)
[       E]   0.238475 d=  0.008871 [   .0 +238474.900] [  0]
[        ]   0.238476 d=  0.000001 [   .0 +238475.833] [  1] Err - bad PID of 0f
PERR: 0001 (Error)
[       E]   0.239591 d=  0.001115 [   .0 +239591.317] [  0]
[        ]   0.239592 d=  0.000001 [   .0 +239592.250] [  1] Err - bad PID of 0f
PERR: 0001 (Error)
[       E]   0.240150 d=  0.000558 [   .0 +240150.067] [  1] Err - bad PID of 0a
[        ]   0.240152 d=  0.000002 [   .0 +240151.667] [  1] Err - bad PID of 0f
PERR: 0001 (Error)
[       E]   0.242733 d=  0.002582 [   .0 +242733.317] [  0]
[        ]   0.242734 d=  0.000001 [   .0 +242734.250] [  1] Err - bad PID of 0f
PERR: 0001 (Error)
[       E]   0.257584 d=  0.014849 [   .0 +257583.567] [  0]
[        ]   0.257584 d=  0.000001 [   .0 +257584.500] [  1] Err - bad PID of 0f

----- >8 -----

PERR: 0001 (Error)
[       E]  33.044570 d=  0.045737 [   .0 +33044569.633] [  0]
[        ]  33.044571 d=  0.000001 [   .0 +33044570.567] [  1] Err - bad PID of 0f
PERR: 0001 (Error)
[       E]  33.084541 d=  0.039970 [   .0 +33084540.717] [  1] Err - bad PID of 0c
[        ]  33.084542 d=  0.000002 [   .0 +33084542.317] [  1] Err - bad PID of 0f
0 / 16777216 (0.00 % utilization) 21 kB | 0 overflow, ffffffff total | R00005748 W00005748
0 overflow, ffffffff total
0 / 16777216 (0.00 % utilization) 21 kB | 0 overflow, ffffffff total | R00005748 W00005748
0 overflow, ffffffff total
0 / 16777216 (0.00 % utilization) 21 kB | 0 overflow, ffffffff total | R00005748 W00005748
0 overflow, ffffffff total
0 / 16777216 (0.00 % utilization) 21 kB | 0 overflow, ffffffff total | R00005750 W00005750
0 overflow, ffffffff total
0 / 16777216 (0.00 % utilization) 21 kB | 0 overflow, ffffffff total | R00005759 W00005759
0 overflow, ffffffff total
PERR: 0001 (Error)
[       E]  33.207216 d=  0.122674 [   .0 +33207216.300] [  0]
[        ]  33.207217 d=  0.000001 [   .0 +33207217.233] [  1] Err - bad PID of 0f
PERR: 0001 (Error)
[       E]  33.438442 d=  0.231225 [   .0 +33438441.783] [  0]
[        ]  33.438443 d=  0.000001 [   .0 +33438442.717] [  1] Err - bad PID of 0f
PERR: 0001 (Error)
[       E]  33.525680 d=  0.087238 [   .0 +33525680.317] [  0]
[        ]  33.525681 d=  0.000001 [   .0 +33525681.250] [  1] Err - bad PID of 0f
PERR: 0001 (Error)
[       E]  33.618852 d=  0.093171 [   .0 +33618852.467] [  0]
0 / 16777216 (0.00 % utilization) 21 kB | 0 overflow, ffffffff total | R00005761 W00005761
0 overflow, ffffffff total
0 / 16777216 (0.00 % utilization) 21 kB | 0 overflow, ffffffff total | R0000576a W0000576a
0 overflow, ffffffff total
0 / 16777216 (0.00 % utilization) 21 kB | 0 overflow, ffffffff total | R0000576a W0000576a
0 overflow, ffffffff total
```

Is this a known issue or something that's been observed before?
It's connected to the front ports of a NUC (NUC8i7BEH).

With just the host connected to J1 (disconnected from J2), things appear to be okay, which hints that this may be an issue with my setup...

```
venv:$ ./software/host/ovctl.py sniff fs
FPGA not loaded, forcing reload
FPGA: Bitstream timestamp 2014/11/10 16:31:07
FPGA: sending configuration bitstream
FPGA: CRC OK
FPGA: configured
0 / 16777216 (0.00 % utilization) 0 kB | 0 overflow, 00c33d5f total | R00000004 W00000004
0 overflow, 02c40b7a total
0 / 16777216 (0.00 % utilization) 0 kB | 0 overflow, 09a1cdd3 total | R00000004 W00000004
0 overflow, 0ba29678 total
0 / 16777216 (0.00 % utilization) 0 kB | 0 overflow, 12803617 total | R00000004 W00000004
0 overflow, 1480ee26 total
0 / 16777216 (0.00 % utilization) 0 kB | 0 overflow, 1b5e9ff9 total | R00000004 W00000004
0 overflow, 1d5f5ab2 total
0 / 16777216 (0.00 % utilization) 0 kB | 0 overflow, 243d2197 total | R00000004 W00000004
0 overflow, 263de1f5 total
0 / 16777216 (0.00 % utilization) 0 kB | 0 overflow, 2d1ba392 total | R00000004 W00000004
0 overflow, 2f1c278b total
0 / 16777216 (0.00 % utilization) 0 kB | 0 overflow, 35fa0a6a total | R00000004 W00000004
0 overflow, 37faaa40 total
0 / 16777216 (0.00 % utilization) 0 kB | 0 overflow, 3ed87628 total | R00000004 W00000004
0 overflow, 40d90a39 total
0 / 16777216 (0.00 % utilization) 0 kB | 0 overflow, 47b6c63e total | R00000004 W00000004
0 overflow, 49b7871b total
0 / 16777216 (0.00 % utilization) 0 kB | 0 overflow, 50953fba total | R00000004 W00000004
0 overflow, 52960368 total
```

---

Some info:

```
$ md5sum software/host/ov3.fwpkg
ea64fd5dcfa0ca710e4b22fd2da42738  software/host/ov3.fwpkg
$ git rev-parse HEAD
61ddaf4afdae046b13e24584fdc59af0fc141ba5
```
```
$ lsb_release -a
No LSB modules are available.
Distributor ID: Ubuntu
Description:    Ubuntu 18.04.2 LTS
Release:        18.04
Codename:       bionic
$ apt show libusb-1.0-0
Package: libusb-1.0-0
Version: 2:1.0.21-2
Priority: standard
Section: libs
Source: libusb-1.0
Origin: Ubuntu
Maintainer: Ubuntu Developers <ubuntu-devel-discuss@lists.ubuntu.com>
Original-Maintainer: Aurelien Jarno <aurel32@debian.org>
Bugs: https://bugs.launchpad.net/ubuntu/+filebug
Installed-Size: 127 kB
Depends: libc6 (>= 2.17), libudev1 (>= 183)
Homepage: http://www.libusb.info
Task: standard
Supported: 5y
Download-Size: 43.3 kB
APT-Manual-Installed: yes
APT-Sources: http://gb.archive.ubuntu.com/ubuntu bionic/main amd64 Packages
Description: userspace USB programming library
 Library for programming USB applications without the knowledge of Linux
 kernel internals.
 .
 This package contains what you need to run programs that use this library.
```

I also had to apply [this patch](https://github.com/attie/ov_ftdi/commit/6171077bf4812ea2ed48a0e069d603c3ace25529) to build it with Ubuntu 18.04's packaged libusb...

somehdlguy, 2019-08-14:
I'm not sure what you are seeing is actually a problem - it looks like that might just be noise or truncated packets on the line. The FPGA is passing back packets received from the USB bus, but they don't have a sane start PID. The OV tries to report exactly what it sees on the line, including corrupt or invalid traffic that would be ignored by a real device.

If you attach a  USB device, do you get good captures/traffic?

attie, 2019-08-15:
Thanks for your response.

I hadn't reviewed the schematic in detail yet, but given the (probably) high impedance of the signals, some garbage might be expected - I don't expect `targetDtap_P` (FPGA pin 105) or `targetDtap_N` (FPGA pin 104) will sink / source current...?

> it looks like that might just be noise or truncated packets on the line
> If you attach a USB device, do you get good captures/traffic?

I think I agree with you - captures appear to be correct, and I don't **remember** seeing the errors with a device connected... I'll look out for them and confirm later.

somehdlguy, 2019-08-15:
targetDtap_P and _N should be high-Z. The entire OV USB path is high-Z and relies on the device/host to do bus termination. (we configure the PHY to leave internal termination off; and the stub length is short enough that reflections shouldn't be _too_ bad).

So, it could be noise on an unterminated high-Z bus. I've also seen hubs leak packets or packet fragments that are destined to other downstream ports; so you might be seeing something like that.

tmbinc, 2019-08-15:
Also keep in mind that we're not auto-sensing speed. So if you're
listening to data at the wrong speed, you likely get interesting things
as well.

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

attie, 2019-08-19:
> I've also seen hubs leak packets or packet fragments that are destined to other downstream ports; so you might be seeing something like that.

Shiny!

> So if you're listening to data at the wrong speed, you likely get interesting things as well.

Understood.

Thanks very much both.

Closed 2019-08-19.

Thread 34 (2019-10-19):

Port openvizsla to artix 7

TomKeddie, 2019-10-19:
I'm opening this issue to track my low but sure effort to port openvizsla to the arty artix-7 board.

I've done a pmod for the USB front end (https://github.com/TomKeddie/prj-pmod/tree/master/hardware/pmod-usb-analyser-openvizla/qfn) and am in the process of verifying the hardware.  Once verified this would let openvizsla run on other hardware more easily.

I've wired the differential pair to match the pair allocation on the arty-7 pmods but it seems these are not used by the hdl at the moment anyway.

The arty _seems_ like a good target
- it's available and not super expensive (they even come up s/h from time to time)
- it is universal hardware so it can be used for more than usb analysis
- it has dram (suitability tbd)
- it has an ft2232h onboard (schematic page is hidden, suitability tbd)
- it has ethernet (ideally I'd like to move to an ethernet transport and remove the dependence of the ft2232h).

Arty schematic is at https://reference.digilentinc.com/_media/reference/programmable-logic/arty/arty_sch.pdf
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

Thread 36 (2019-10-30):

FPGA Models: XC6SLX9-2TQG144C vs. XC6SLX9-3TQG144C (speed)

rljacobson, 2019-10-30:
The BOM specifies an `XC6SLX9-3TQG144C` FPGA. The `3` after the `-` is the "speed grade" [according to the datasheet](https://www.xilinx.com/support/documentation/data_sheets/ds160.pdf). I can buy four `XC6SLX9-2TQG144C`s (speed grade 2) for the cost of one `XC6SLX9-3TQG144C`.

Can anyone tell me if the `XC6SLX9-2TQG144C` is fast enough for and compatible with this application?

This isn't a tool I necessarily need. I got the [PCB for 1€ at sysmocom.de](http://shop.sysmocom.de/t/usb/tracer-analyzer) and plan to assemble it bit by bit as I acquire the parts for the experience. (If anyone else is reading this, sysmocom.de is selling the kit for 47€, which is a bargain, IMHO.)

LoveMHz, 2020-01-31:
I also would be interested in knowing if the XC6SLX9-2TQG144C is a suitable substitute. I'm not familiar enough with the project to discern if it would work, but the [DC and Switching Characteristic datasheet](https://www.xilinx.com/support/documentation/data_sheets/ds162.pdf) has more information on the speed grade differences.

laf0rge, 2021-03-11:
we (at symocom) have also been wondering if the othe r(more easily sourceable) speed grade is suitable.  However, we just use and sell the boards (and soon will produce more) and have not been involved in the design phase of this project.  I guess somebody will have to try to build the bitstream with the timing parameters of the othe speed grade and actually test...

Thread 41 (2020-09-14):

"Sigrok integration"

dogtopus, 2020-09-14:
So I saw

>Integration with sigrok would be nice to show the packet level of USB.

and made [this](https://github.com/dogtopus/usbll2sr) out of boredom.

It's honestly pretty useless since Wireshark already shows the packet-level detail and PCAP won't provide signal integrity stuff. However it still looks cool. If anyone think it's a good idea to include it in the README feel free to do so :stuck_out_tongue_winking_eye:.

laf0rge, 2021-03-11:
sorry for the late response.  I certainly would appreciate and support any pull request linking to "third party" FOSS that can be used with ov_ftdi.

Closed 2023-05-13.

Thread 42 (2021-01-06):

Errata: bad silk screen on P4 for 1.2v and 5v

lf-, 2021-01-06:
On the schematic, the label for pin 23 of the header is 1.2v. This is correct according to tracing the trace on my v3.2 board. However, the silk screen on that one says 5v, and the silk screen for pin 24 says 1.2v. These are inaccurate.

msweef, 2021-03-23:
Thanks, this is adressed in c375a95 which gets merged very soon. - If you are aware of similar silk screen errors, please report.

msweef, 2021-04-12:
The error has been fixed as a part of https://github.com/openvizsla/ov_ftdi/pull/46 which just was merged.

Closed 2021-05-31.

Thread 49 (2021-04-23):

Question about 3.3 changes

pk-r7, 2021-04-23:
How critical is the copper thickness on the internal layers? I wanted to do a prototype run based on these changes but small volume and the 1 oz internal seems to be an issue right now. I can get JLCPCB compliant with all the other specifications except 1 oz on the inner layers.

laf0rge, 2021-05-31:
sorry for the late response, we don't really use the issue tracker as discussion forum much.

I don't think it matters much if you have lower copper thickness.  The only critical part is the space between top and inner layer, as that is relevant to the impedance of the USB traces.

Closed 2021-05-31.

Thread 52 (2022-09-29):

Feature request: USB generator

desowin, 2022-09-29:
It would be really nice to be able to use OpenVizsla to generate USB bus traffic. I would especially like the gateware/software to implement USB host functionality. The host functionality would allow to test whether the device properly handles error conditions like missing ACK or CRC errors, as the errors would be simply scheduled to happen.

I don't know if there is any OpenSource project that already implements such functionality.

#### Gateware requirements

The gateware would have to support:
- Speed selection (LS/FS/HS)
- Automated SOF generator (controlled from software, but has to be handled by gateware due to timing requirements)
- Transaction handling (e.g. "IN addr 0 ep 0" would make the gateware to send IN packet, wait for DATA packet and acknowledge it, returning the DATA to software)

To simplify the design and improve performance, I think the actual capture could be optional (i.e. if user has multiple units, one would act as generator the other as capture).

The mixed speed (LS transaction followed by FS PRE and SPLIT transactions) are not really essential at the initial stage, but the gateware design should accommodate it.

#### Software considerations

The software would have to support enumeration (read DEVICE, CONFIGURATION and STRING descriptors and SET ADDRESS). Actual USB handling is probably best left to existing USB stacks. The existing USB stacks can be integrated by implementing USBIP server (OpenVizsla generator software would be USBIP server) - that way only the URB handling would have to be implemented to have a fully working stack. When USBIP server is active it would be nice to have some fault injection mechanism, e.g. corrupt CRC of every 5th OUT bulk packet.

When USBIP is not used, the software should allow manually triggering actions, to allow predefined and/or user-defined compliance-like testcases.

laf0rge, 2022-09-29:
I think this is more in the scope of https://github.com/greatscottgadgets/luna than OpenVizsla.  OpenVizsla was - AFAICT - always about *passive tracing* and not anything else.

Thread 53 (2022-10-06):

LibOV.ProtocolError: Checksum for response incorrect

defencore, 2022-10-06:
When I try to sniff traffic between the Android and the DJI RC, I get an error:

```
# Board: OpenVizsla v3.3
└─$ ./software/host/ovctl.py -l sniff hs
```

```
PERR: 1FD0 (First)
[   F    ]  11.586765 d=  0.007282 [178   +1688811.583] [  0]
Exception in thread Thread-1 (__comms):
Traceback (most recent call last):
  File "/usr/lib/python3.10/threading.py", line 1016, in _bootstrap_inner
    self.run()
  File "/usr/lib/python3.10/threading.py", line 953, in run
    self._target(*self._args, **self._kwargs)
  File "/tmp/ov_ftdi/software/host/LibOV.py", line 637, in __comms
    raise self.__comm_exc
  File "/tmp/ov_ftdi/software/host/LibOV.py", line 616, in callback
    code = service.presentBytes(self.__buf)
  File "/tmp/ov_ftdi/software/host/LibOV.py", line 310, in presentBytes
    self.consume(b[:size])
  File "/tmp/ov_ftdi/software/host/LibOV.py", line 332, in consume
    raise ProtocolError(
LibOV.ProtocolError: Checksum for response incorrect: expected 76, got 01
```

desowin, 2022-10-07:
Is this related to #13? Do you get similar issue when using [ovextcap](https://github.com/matwey/libopenvizsla/tree/master/tools/ovextcap)? The libopenvizsla [unconditionally forces firmware download](https://github.com/matwey/libopenvizsla/pull/27) while ov_ftdi does not.

Thread 54 (2022-12-08):

Feature request: Full-Speed PRE handling

desowin, 2022-12-08:
Currently the capture speed is fixed for a capture session duration. This is always fine for High-Speed and Low-Speed captures and mostly fine for Full-Speed captures. There is one corner case when it is not fine for Full-Speed captures: when capture the link between host and hub while there is Low-Speed device connected.

Due to very strict timings, the speed change must be handled by FPGA. The Low-Speed packet captured on Full-Speed link should probably be indicated with new flag. `Universal Serial Bus Specification Revision 2.0` section `8.6.5 Low-speed Transactions` describes what is sent at Full-Speed and what at Low-Speed.

To obtain best Wireshark experience, the data would have to be written to pcapng format. I can handle the pcapng related work if the bitstream handles the PRE processing and sets low-speed flag on packets.

Thread 57 (2023-04-09):

Openvizsla sniffing nothing (but transfer amount continues to go up)

jaysonlarose, 2023-04-09:
I'm trying to reliably capture data sent between a Nintendo Switch Pro Controller and a Nintendo Switch.

Sometimes this works fine, but more often than not, this sort of situation occurs:

```bash
jayson@grillex % ./ovctl.py sniff fs
Unmatched byte 76 - discarding
Unmatched byte a5 - discarding
Unmatched byte 3f - discarding
Unmatched byte 86 - discarding
0 / 16777216 (0.00 % utilization) 1 kB | 0 overflow, 00c32914 total | R00000713 W00000713
0 overflow, 02c3fb67 total
0 / 16777216 (0.00 % utilization) 15 kB | 0 overflow, 09a1cab5 total | R00003c4d W00003c4d
0 overflow, 0ba2e796 total
0 / 16777216 (0.00 % utilization) 28 kB | 0 overflow, 12803072 total | R0000712c W0000712c
0 overflow, 1480db1b total
0 / 16777216 (0.00 % utilization) 41 kB | 0 overflow, 1b5e99f4 total | R0000a606 W0000a606
0 overflow, 1d5f5e46 total
0 / 16777216 (0.00 % utilization) 54 kB | 0 overflow, 243d0d77 total | R0000dafa W0000dafa
0 overflow, 263de83f total
0 / 16777216 (0.00 % utilization) 67 kB | 0 overflow, 2d1b81df total | R00010fee W00010fee
0 overflow, 2f1c1c82 total
0 / 16777216 (0.00 % utilization) 81 kB | 0 overflow, 35f9d61b total | R000144e2 W000144e2
0 overflow, 37fab6f6 total
0 / 16777216 (0.00 % utilization) 94 kB | 0 overflow, 3ed84eca total | R000179c2 W000179c2
0 overflow, 40d8e51e total
0 / 16777216 (0.00 % utilization) 107 kB | 0 overflow, 47b6c270 total | R0001ae7c W0001ae7c
0 overflow, 49b76b7e total
0 / 16777216 (0.00 % utilization) 120 kB | 0 overflow, 50952b1b total | R0001e35b W0001e35b
0 overflow, 5295cef4 total
0 / 16777216 (0.00 % utilization) 134 kB | 0 overflow, 59739841 total | R00021864 W00021864
0 overflow, 5b748513 total
0 / 16777216 (0.00 % utilization) 147 kB | 0 overflow, 6252efca total | R00024d52 W00024d52
0 overflow, 6452a151 total
0 / 16777216 (0.00 % utilization) 160 kB | 0 overflow, 6b306eb2 total | R00028232 W00028232
0 overflow, 6d312fc4 total
0 / 16777216 (0.00 % utilization) 173 kB | 0 overflow, 740ed717 total | R0002b711 W0002b711
0 overflow, 760f9a02 total
```

The LED next to the FPGA is dimly lit in the same way that it is when sniffing is working, and the kB value is increasing, but no packets are being displayed.

This behavior appears to be "sticky", that is, when sniffing works, chances are ok (if I had to put a number on it, I'd say maybe 75%?) that sniffing will work again if you stop and start the process... but when sniffing doesn't work, chances are very good (I'd say around 90%) that it'll continue to not work.

When it's not working, resetting the USB devices (ie, via the 'usbreset' command) doesn't seem to help any more than just trying again and hoping for the best.

This is only a full speed connection I'm dealing with, so I'd assume this board would have no problems whatsoever dealing with communications between a controller and a games console.  Is there anything I can do to get it to be more reliable?  Or to more fully reset the thing back into a state where I know it'll start sniffing properly when I ask it to do so?

I _am_ using some rather long USB cables to connect between the console and the controller, but as the Switch is having no problems whatsoever picking up what the controller is putting down, I assume this isn't an issue.

Or, occasionally, something like this happens:

```bash
Unmatched byte 03 - discarding
Unmatched byte 00 - discarding
Unmatched byte 7b - discarding
Unmatched byte 8e - discarding
Unmatched byte d6 - discarding
Unmatched byte a5 - discarding
Unmatched byte 24 - discarding
PERR: 00A0 (Last)
Unmatched byte 03 - discarding
Unmatched byte 00 - discarding
Unmatched byte 98 - discarding
Unmatched byte 43 - discarding
Unmatched byte fa - discarding
Unmatched byte a5 - discarding
Unmatched byte 4b - discarding
Unmatched byte 78 - discarding
Traceback (most recent call last):
File "/home/jayson/Git/ov_ftdi/software/host/ovctl.py", line 628, in <module>
main()
File "/home/jayson/Git/ov_ftdi/software/host/ovctl.py", line 621, in main
args.hdlr.go(dev, args)
File "/home/jayson/Git/ov_ftdi/software/host/ovctl.py", line 422, in go
do_sniff(dev, args.speed, args.format, args.out, args.timeout)
File "/home/jayson/Git/ov_ftdi/software/host/ovctl.py", line 279, in do_sniff
dev.regs.LEDS_MUX_2.wr(0)
File "/home/jayson/Git/ov_ftdi/software/host/LibOV.py", line 210, in wr
self.writefn(self.addr + self.size - 1 - i, (value >> (i * 8)) & 0xFF)
File "/home/jayson/Git/ov_ftdi/software/host/LibOV.py", line 791, in iowrite
return self.io.do_write(self.resolve_addr(addr), value)
File "/home/jayson/Git/ov_ftdi/software/host/LibOV.py", line 346, in do_write
return self.__txn(0x8000 | addr, value, timeout)
File "/home/jayson/Git/ov_ftdi/software/host/LibOV.py", line 363, in __txn
assert r_addr == io_ext
AssertionError
```

And very occasionally, it'll do this:

```bash
jayson@grillex % ./mister_viz_openvizsla.py
Unmatched byte e9 - discarding
Unmatched byte 94 - discarding
Unmatched byte d2 - discarding
PERR: D000 ()
Unmatched byte df - discarding
Unmatched byte aa - discarding
Unmatched byte e1 - discarding
Unmatched byte 02 - discarding
Unmatched byte 81 - discarding
Unmatched byte 01 - discarding
Unmatched byte 40 - discarding
Unmatched byte 40 - discarding
Unmatched byte 85 - discarding
Unmatched byte cd - discarding
Unmatched byte 00 - discarding
Unmatched byte 03 - discarding
Unmatched byte 00 - discarding
Unmatched byte 56 - discarding
Unmatched byte 32 - discarding
Unmatched byte 37 - discarding
Unmatched byte a5 - discarding
Unmatched byte 91 - discarding
Unmatched byte 1c - discarding
Unmatched byte 94 - discarding
Unmatched byte dc - discarding
Unmatched byte 3d - discarding
Unmatched byte 5a - discarding
Unmatched byte 9e - discarding
Unmatched byte 14 - discarding
Unmatched byte 0e - discarding
Unmatched byte c5 - discarding
Unmatched byte a1 - discarding
Unmatched byte 74 - discarding
Unmatched byte a7 - discarding
Unmatched byte f4 - discarding
Unmatched byte ff - discarding
Unmatched byte da - discarding
Unmatched byte 00 - discarding
Unmatched byte f4 - discarding
Unmatched byte 07 - discarding
Unmatched byte 80 - discarding
Unmatched byte f0 - discarding
Unmatched byte 87 - discarding
Unmatched byte 80 - discarding
Unmatched byte 0b - discarding
Unmatched byte 72 - discarding
Unmatched byte 03 - discarding
Unmatched byte 2d - discarding
Unmatched byte 00 - discarding
Unmatched byte 17 - discarding
Unmatched byte 10 - discarding
Unmatched byte fc - discarding
Unmatched byte ff - discarding
Unmatched byte f9 - discarding
Unmatched byte ff - discarding
Unmatched byte 00 - discarding
Unmatched byte 00 - discarding
Unmatched byte 70 - discarding
Unmatched byte 03 - discarding
Unmatched byte 1c - discarding
Unmatched byte 00 - discarding
Unmatched byte 2e - discarding
Unmatched byte 10 - discarding
Unmatched byte fb - discarding
Unmatched byte ff - discarding
Unmatched byte fb - discarding
Unmatched byte ff - discarding
Unmatched byte 00 - discarding
Unmatched byte 00 - discarding
Unmatched byte 97 - discarding
Unmatched byte 03 - discarding
Unmatched byte 3f - discarding
Unmatched byte f5 - discarding
Unmatched byte ff - discarding
Unmatched byte fd - discarding
Unmatched byte ff - discarding
PERR: 4040 ()
Unmatched byte 00 - discarding
Unmatched byte 00 - discarding
Unmatched byte 00 - discarding
Unmatched byte 00 - discarding
Unmatched byte 00 - discarding
Unmatched byte 00 - discarding
Unmatched byte 00 - discarding
Unmatched byte d6 - discarding
Unmatched byte a9 - discarding
( at this point, the LED blinking stops, as if the viszla has given up )
```

desowin, 2023-04-09:
Do you observe the same with latest software from https://github.com/OpenVizslaTNG/ov_ftdi ?

How do you connect the Pro Controller with Switch via OpenVizlsa? What type of cables/usb-c adapters do you use?

desowin, 2023-04-09:
To force fpga gateware reset, just add `--load` before `sniff`.

jaysonlarose, 2023-04-09:
Hi! Thanks for responding!

I didn't know anything about  this OpenvizslaTNG repository! I'll have to give it a try!

I found (only in the past 60 minutes or so) that making sure I always call ovctl with the `-l` flag so that it reloads the FPGA gateware seems to give me good results.  I'm reliably able to see the data transfer between controller and console.

I'm using no-name USB cables, nothing real special.

The Switch -&gt; openvizsla cable is a monoprice cable that I bought maybe 8 years ago, it's about 10 feet long and I've never used it until now.

The openvizsla -&gt; pro controller cable is this weird USB A to C cable that has magnets embedded periodically throughout its length.... it's branded "Supercalla".

The openvizsla -&gt; analysis computer cable is another monoprice cable I've had since forever.

The printing on both of the Monoprice cables says "USB2.0 SHIELDED HIGH SPEED CABLE"

jaysonlarose, 2023-04-09:
Yes, exactly! Using `--load` is the magic bullet that basically solved my issues.  Now, onto the fun stuff :)

jaysonlarose, 2023-04-09:
(closing issue as "completed")
