openvizsla/ov_ftdi/(list of files, drawings)

Other design files:
hardware/FPGA power v3.SchDoc
hardware/fpga.SchDoc
hardware/OpenVizsla footprints.PcbLib
hardware/OpenVizsla symbols.SchLib
hardware/ov_ftdi1/ov_ftdi.PcbLib
hardware/ov_ftdi1/ov_ftdi.SCHLIB
hardware/ov_ftdi.PcbDoc
hardware/ov_ftdi.PrjPcb
hardware/power.SchDoc
hardware/Project Outputs for ov_ftdi/Exporter Wrapper/ov_ftdi.PCB
hardware/RAM and target USB.SchDoc
hardware/usb.SchDoc
