openvizsla/ov_ftdi/software/fpga/ov3/ovhw/sdram_sink.py

from migen import *
from migen.genlib.fsm import FSM, NextState
from migen.genlib.fifo import SyncFIFO
from misoc.interconnect.csr import AutoCSR, CSRStatus, CSRStorage
from misoc.interconnect.stream import Endpoint

from ovhw.whacker.util import Acc, Acc_inc
from ovhw.perfcounter import Perfcounter

class SDRAM_Sink(Module, AutoCSR):
    def __init__(self, hostif, max_burst_length = 256):
        width = len(hostif.d_write)
        assert width == 16

        awidth = len(hostif.i_addr) + 1

        self.sink = Endpoint([('d', 8), ('last', 1)])

        self.submodules.sdram_fifo = SyncFIFO(width, max_burst_length)

        self.submodules.fifo_write_fsm = FSM()

        self.wptr = Signal(awidth)

        # rptr (from SDRAM Source)
        self.rptr = Signal(awidth)

        # CSRs

        self._ptr_read = CSRStorage(1)
        ptr_read = self._ptr_read.re
        self._wptr = CSRStatus(awidth)
        self.sync += If(ptr_read, self._wptr.status.eq(self.wptr))
        self._rptr = CSRStatus(awidth)
        self.sync += If(ptr_read, self._rptr.status.eq(self.rptr))

        self._ring_base = CSRStorage(awidth)
        self._ring_end = CSRStorage(awidth)
        self._go = CSRStorage(1)

        go = self._go.storage[0]

        # 'go'-signal edge detect
        gor = Signal()
        self.sync += gor.eq(go)

        self._wrap_count = Perfcounter(ptr_read, go &~ gor)

        # wptr wrap around

        wrap = Signal()
        self.comb += wrap.eq(self.wptr == self._ring_end.storage)
        wptr_next = Signal(awidth)
        self.comb += If(wrap, wptr_next.eq(self._ring_base.storage)).Else(wptr_next.eq(self.wptr + 1))

        # debug

        self._debug_ctl = CSRStorage(1)
        snapshot = self._debug_ctl.re
        perf_reset = self._debug_ctl.storage[0]
        self._debug_i_stb = Perfcounter(snapshot, perf_reset)
        self._debug_i_ack = Perfcounter(snapshot, perf_reset)
        self._debug_d_stb = Perfcounter(snapshot, perf_reset)
        self._debug_d_term = Perfcounter(snapshot, perf_reset)
        self._debug_s0 = Perfcounter(snapshot, perf_reset)
        self._debug_s1 = Perfcounter(snapshot, perf_reset)
        self._debug_s2 = Perfcounter(snapshot, perf_reset)
        self._perf_busy = Perfcounter(snapshot, perf_reset)

        self.comb += If(hostif.i_stb, self._debug_i_stb.inc())
        self.comb += If(hostif.i_ack, self._debug_i_ack.inc())
        self.comb += If(hostif.d_stb, self._debug_d_stb.inc())
        self.comb += If(hostif.d_term, self._debug_d_term.inc())
        self.comb += If(~self.sdram_fifo.writable, self._perf_busy.inc())

        # FSM to move FIFO data to SDRAM

        burst_rem = Signal(max = max_burst_length)
        burst_rem_next = Signal(max = max_burst_length)

        self.comb += burst_rem_next.eq(burst_rem)
        self.sync += burst_rem.eq(burst_rem_next)

        self.comb += hostif.i_wr.eq(1)

        blocked = Signal()

        self.comb += blocked.eq(self.rptr == wptr_next)

        # start writing data if
        # - 'go'-signal set, and
        # - input data available
        # - not blocked

        self.fifo_write_fsm.act("IDLE",
            self._debug_s0.inc(),
            If(self.sdram_fifo.readable & go & ~blocked,
                hostif.i_addr.eq(self.wptr),
                hostif.i_stb.eq(1),
                burst_rem_next.eq(max_burst_length - 1)
            ),
            If(hostif.i_ack,
                NextState("WRITE")
            )
        )

        self.comb += hostif.d_write.eq(self.sdram_fifo.dout)

        # stop writing if 
        # - max burst length reached, or
        # - no more input data, or
        # - wrap
        # - blocked

        self.fifo_write_fsm.act("WRITE",
            self._debug_s1.inc(),
            hostif.d_term.eq((burst_rem == 0) | ~self.sdram_fifo.readable | wrap | blocked),
            self.sdram_fifo.re.eq(hostif.d_stb &~ hostif.d_term),
            If(~hostif.d_term & hostif.d_stb,
                burst_rem_next.eq(burst_rem - 1) # CHECKME: was burst_rem_next - 1 which is a comb loop
            ),
            If(hostif.d_term & ~hostif.d_stb,
                NextState("WAIT")
            ).Elif(hostif.d_term & hostif.d_stb,
                NextState("IDLE")
            )
        )

        self.fifo_write_fsm.act("WAIT",
            self._debug_s2.inc(),
            hostif.d_term.eq(1),
            If(hostif.d_stb,
                NextState("IDLE")
            )
        )


        # wrap around counter
        self.comb += If(wrap & hostif.d_stb &~ hostif.d_term, self._wrap_count.inc())

        # update wptr
        self.sync += If(go &~ gor,
                self.wptr.eq(self._ring_base.storage),
            ).Elif((hostif.d_stb &~ hostif.d_term) | wrap,
                self.wptr.eq(wptr_next)
            )

        # sink into fifo

        self.submodules.fifo_fsm = FSM()

        capture_low = Signal()
        din_low = Signal(8)

        self.comb += self.sdram_fifo.din.eq(Cat(din_low, self.sink.payload.d))

        self.sync += If(capture_low, din_low.eq(self.sink.payload.d))

        self.fifo_fsm.act("READ_LOW",
            capture_low.eq(1),
            self.sink.ack.eq(1),
            If(self.sink.stb,
                NextState("READ_HI")
            )
        )

        self.fifo_fsm.act("READ_HI",
            self.sdram_fifo.we.eq(self.sink.stb),
            self.sink.ack.eq(self.sdram_fifo.writable),
            If(self.sink.ack & self.sink.stb,
                NextState("READ_LOW")
            )
        )
