openvizsla/ov_ftdi/software/fpga/ov3/ovhw/top.py

#!/usr/bin/env python3

from migen import *
from migen.genlib.record import Record
import misoc.interconnect.stream as al_fifo
from misoc.interconnect.csr_bus import Interconnect, CSRBankArray

import ovhw.clocking as clocking
from ovhw.sdramctl import SDRAMCTL
from ovhw.sdram_mux import SDRAMMux
from ovhw.sdram_bist import SDRAMBIST
from ovhw.sdrambistcfg import SDRAMBISTCfg
from ovhw.ulpi import ULPI_ctrl, ULPI_pl, ULPI_REG
from ovhw.leds import LED_outputs
from ovhw.buttons import BTN_status
from ovhw.whacker.whacker import Whacker
from ovhw.ovf_insert import OverflowInserter
from ovhw.cmdproc import CmdProc
from ovhw.ftdi_bus import FTDI_sync245
from ovhw.ftdi_lfsr_test import FTDI_randtest
from ovhw.ulpicfg import ULPICfg
from ovhw.cfilt import RXCmdFilter
from ovhw.ov_types import ULPI_DATA_D
from ovhw.sdram_host_read import SDRAM_Host_Read
from ovhw.sdram_sink import SDRAM_Sink
import ovplatform.sdram_params

# Top level platform module
class OV3(Module):
    def __init__(self, plat):
        # Clocking

        clk_ref = plat.request("clk12") # 12mhz reference clock from which all else is derived

        self.submodules.clockgen = clocking.ClockGen(clk_ref)
        self.clock_domains.cd_sys = self.clockgen.cd_sys

        # SDRAM Controller
        sd_param = ovplatform.sdram_params.getSDRAMParams('mt48lc16m16a2')

        # Build the SDRAM controller (TODO: Replace with MISOC SDRAM controller)
        self.submodules.sdramctl = SDRAMCTL(
            plat.request("sdram"),
            clk_out=self.clockgen.clk_sdram,
            clk_sample=self.clockgen.clk_sdram_sample,
            **sd_param._asdict()
        )

        # SDRAM Master arbiter (TODO: Replace with MISOC bus arbiter)
        self.submodules.sdram_mux = SDRAMMux(self.sdramctl.hostif)

        # SDRAM BIST (TODO: Rewrite to use internal bus)
        memsize = 2 ** (sd_param.colbits + sd_param.rowbits + sd_param.bankbits)
        self.submodules.bist = SDRAMBIST(self.sdram_mux.getPort(), memsize)
        self.submodules.sdram_test = SDRAMBISTCfg(self.bist)

        # SDRAM host read translator
        self.submodules.sdram_host_read = SDRAM_Host_Read(self.sdram_mux.getPort(), host_burst_length = 0x20)
        
        # SDRAM sink - sends data from USB capture to host
        self.submodules.sdram_sink = SDRAM_Sink(self.sdram_mux.getPort())
        
        # connect wptr/rptr for ringbuffer flow control
        self.comb += self.sdram_host_read.wptr.eq(self.sdram_sink.wptr)
        self.comb += self.sdram_sink.rptr.eq(self.sdram_host_read.rptr)

        # ULPI Interfce

        # Diagnostics/Testing signals
        ulpi_cd_rst = Signal()
        ulpi_stp_ovr = Signal(1)
        
        # ULPI physical layer
        self.submodules.ulpi_pl = ULPI_pl(
            plat.request("ulpi"), ulpi_cd_rst, ulpi_stp_ovr)
        self.clock_domains.cd_ulpi = self.ulpi_pl.cd_ulpi
        
        # ULPI controller
        ulpi_reg = Record(ULPI_REG)
        self.submodules.ulpi = ClockDomainsRenamer({"sys": "ulpi"}) (
          ULPI_ctrl(self.ulpi_pl.ulpi_bus, ulpi_reg),
        )

        # ULPI register R/W CSR interface
        self.submodules.ucfg = ULPICfg(
            self.cd_ulpi.clk, ulpi_cd_rst, self.ulpi_pl.ulpi_bus.rst,
            ulpi_stp_ovr, ulpi_reg)


        # Receive Path
        self.submodules.ovf_insert = ClockDomainsRenamer(
            {"sys": "ulpi"}
        )(OverflowInserter())

        self.submodules.udata_fifo = ClockDomainsRenamer(
            {"write":"ulpi", "read":"sys"})(
            al_fifo.AsyncFIFO(ULPI_DATA_D, 1024)
        )

        self.submodules.cfilt = RXCmdFilter()
        self.submodules.cstream = Whacker(1024)

        self.comb += [
                self.ulpi.data_out_source.connect(self.ovf_insert.sink),
                self.ovf_insert.source.connect(self.udata_fifo.sink),
                self.udata_fifo.source.connect(self.cfilt.sink),
                self.cfilt.source.connect(self.cstream.sink),
                self.cstream.source.connect(self.sdram_sink.sink),
                ]

        # FTDI bus interface
        ftdi_io = plat.request("ftdi")
        self.submodules.ftdi_bus = ftdi_bus = FTDI_sync245(self.clockgen.cd_sys.rst,
                ftdi_io)

        # FTDI command processor
        self.submodules.randtest = FTDI_randtest()
        self.submodules.cmdproc = CmdProc(self.ftdi_bus,
                [self.randtest, self.sdram_host_read])

        # GPIOs (leds/buttons)
        self.submodules.leds = LED_outputs(plat.request('leds'),
                [
                    [self.bist.busy, self.ftdi_bus.tx_ind],
                    [0, self.ftdi_bus.rx_ind],
                    [0]
                ], active=0)

        self.submodules.buttons = BTN_status(~plat.request('btn'))


        # Bind all device CSRs
        self.csr_map = {
                'leds': 0,
                'buttons' : 1,
                'ucfg' : 2,
                'randtest' : 3,
                'cstream' : 4,
                'sdram_test' : 5,
                'sdram_host_read' : 6,
                'sdram_sink' : 7,
                'ovf_insert' : 8,
                }

        self.submodules.csrbankarray = CSRBankArray(self,
            lambda name, _: self.csr_map[name])

        # Connect FTDI CSR Master to CSR bus
        self.submodules.incon = Interconnect(self.cmdproc.master, self.csrbankarray.get_buses())
