openvizsla/ov_ftdi/software/host/elf.h

/* elf header definitions */
#ifndef __ELF_H__
#define __ELF_H__

#include <stdint.h>

#define EI_NIDENT 16

typedef struct {
	unsigned char   e_ident[EI_NIDENT];
	uint16_t e_type;
	uint16_t e_machine;
	uint32_t e_version;
	uint32_t e_entry;
	uint32_t e_phoff;
	uint32_t e_shoff;
	uint32_t e_flags;
	uint16_t e_ehsize;
	uint16_t e_phentsize;
	uint16_t e_phnum;
	uint16_t e_shentsize;
	uint16_t e_shnum;
	uint16_t e_shtrndx;
} Elf32_Ehdr;

typedef struct {
	uint32_t p_type;
	uint32_t p_offset;
	uint32_t p_vaddr;
	uint32_t p_paddr;
	uint32_t p_filesz;
	uint32_t p_memsz;
	uint32_t p_flags;
	uint32_t p_align;
} Elf32_Phdr;

#define PT_NULL     0
#define PT_LOAD     1
#define PT_DYNAMIC  2
#define PT_INTERP   3
#define PT_NOTE     4
#define PT_SHLIB    5
#define PT_PHDR     6

#define EI_MAG0         0               /* e_ident[] indexes */
#define EI_MAG1         1
#define EI_MAG2         2
#define EI_MAG3         3
#define EI_CLASS        4
#define EI_DATA         5
#define EI_VERSION      6
#define EI_OSABI        7
#define EI_PAD          8

#define ELFMAG0         0x7f            /* EI_MAG */
#define ELFMAG1         'E'
#define ELFMAG2         'L'
#define ELFMAG3         'F'
#define ELFMAG          "\177ELF"
#define SELFMAG         4
 
#define ELFCLASSNONE    0               /* EI_CLASS */
#define ELFCLASS32      1
#define ELFCLASS64      2
#define ELFCLASSNUM     3

#define ELFDATANONE     0               /* e_ident[EI_DATA] */
#define ELFDATA2LSB     1
#define ELFDATA2MSB     2

#define EV_NONE         0               /* e_version, EI_VERSION */
#define EV_CURRENT      1
#define EV_NUM          2

/* These constants define the permissions on sections in the program
   header, p_flags. */
#define PF_R            0x4
#define PF_W            0x2
#define PF_X            0x1
#endif
