openvizsla/ov_ftdi/(commit log)

2013-06-19 replaced ascii versions with binary versions
    [FPGA power v3.SchDoc, OpenVizsla footprints.PcbLib, OpenVizsla symbols.SchLib, RAM v3.SchDoc, fpga.SchDoc, ov_ftdi.PcbDoc, ov_ftdi.PrjPcb, power.SchDoc]
2013-06-20 swap BCBUS and BDBUS on FTDI
    [ov_ftdi.PcbDoc, ov_ftdi.PrjPcb, usb.SchDoc]
2013-06-20 convert FTDI USB jack to USB A
    [ov_ftdi.PcbDoc, usb.SchDoc]
2013-06-20 change target USB connector from USB mini AB to USB B
    [ov_ftdi.PcbDoc, target USB interfaces v3.SchDoc]
2013-06-21 move all components to top side of PCB
    [ov_ftdi.PcbDoc]
2013-06-23 move most power signals to outer layers
    [ov_ftdi.PcbDoc]
2013-06-23 add TL1105 tact switch footprint
    [OpenVizsla footprints.PcbLib]
2013-06-23 switch to new tact switch
    [OpenVizsla footprints.PcbLib, fpga.SchDoc, ov_ftdi.PcbDoc]
2013-06-23 route all the things
    [fpga.SchDoc, ov_ftdi.PcbDoc]
2013-06-23 convert down to 2 layer
    [fpga.SchDoc, ov_ftdi.PcbDoc, ov_ftdi.PrjPcb]
2013-06-26 clean up parameters
    [FPGA power v3.SchDoc, RAM v3.SchDoc, fpga.SchDoc, ov_ftdi.PcbDoc, power.SchDoc, target USB interfaces v3.SchDoc, usb.SchDoc]
2013-06-26 more cleanup
    [FPGA power v3.SchDoc, RAM v3.SchDoc, ov_ftdi.PcbDoc, power.SchDoc, target USB interfaces v3.SchDoc, usb.SchDoc]
2013-06-26 route power
    [ov_ftdi.PcbDoc]
2013-06-26 re-enable polygon pours
    [ov_ftdi.PcbDoc]
2013-06-26 fix 12MHz xtal footprint
    [ov_ftdi.PcbDoc, usb.SchDoc]
2013-06-26 begin to fix silkscreen designators
    [ov_ftdi.PcbDoc]
2013-06-27 remove current sense circuitry
    [ov_ftdi.PcbDoc, target USB interfaces v3.SchDoc]
2013-06-27 fix DRC check
    [fpga.SchDoc, ov_ftdi.PcbDoc, ov_ftdi.PrjPcb, target USB interfaces v3.SchDoc]
2013-06-27 USB D+/D- -> 50mils
    [ov_ftdi.PcbDoc]
2013-06-27 add outjob
    [OpenVizsla footprints.PcbLib, ov_ftdi.PcbDoc, ov_ftdi.PrjPcb]
2013-06-27 switch PHY to USB3343 move targetULPI_CLK to a GCLK input on the FPGA
    [OpenVizsla footprints.PcbLib, OpenVizsla symbols.SchLib, fpga.SchDoc, ov_ftdi.PcbDoc, target USB interfaces v3.SchDoc]
2013-06-27 add FTDI JTAG wiring
    [ov_ftdi.PcbDoc, usb.SchDoc]
2013-06-27 added oscillator for bringup
    [OpenVizsla footprints.PcbLib, fpga.SchDoc, ov_ftdi.PcbDoc, ov_ftdi.PrjPcb]
2013-06-27 move USB A connector towards inside of board
    [ov_ftdi.PcbDoc, target USB interfaces v3.SchDoc]
2013-06-27 switch to horizontal-mount USB A jack
    [ov_ftdi.PcbDoc, target USB interfaces v3.SchDoc]
2013-06-27 make QFN footprints longer
    [OpenVizsla footprints.PcbLib, ov_ftdi.PcbDoc]
2013-06-27 rounded PCB corners
    [ov_ftdi.PcbDoc]
2013-06-28 fix color outjob, add legend
    [OpenVizsla footprints.PcbLib, ov_ftdi.PcbDoc, ov_ftdi.PrjPcb, target USB interfaces v3.SchDoc]
2013-06-28 tent all vias on top
    [ov_ftdi.PcbDoc]
2013-06-28 change 0402 label to 0603
    [FPGA power v3.SchDoc, RAM v3.SchDoc, fpga.SchDoc, power.SchDoc, target USB interfaces v3.SchDoc, usb.SchDoc]
2013-06-28 clean up power supply caps on schematic
    [FPGA power v3.SchDoc, ov_ftdi.PcbDoc, power.SchDoc]
2013-06-28 schematic cleanups
    [RAM v3.SchDoc, fpga.SchDoc, ov_ftdi.PcbDoc, target USB interfaces v3.SchDoc, usb.SchDoc]
2013-06-28 enlarge silkscreen reference designators
    [ov_ftdi.PcbDoc]
2013-06-28 more silkscreen cleanup
    [ov_ftdi.PcbDoc]
2013-06-28 add board size legend for Mech2 (acrylic cover)
    [ov_ftdi.PcbDoc]
2013-06-29 fix minimum solder mask sliver errors
    [ov_ftdi.PcbDoc]
2013-06-29 add ground clip points ala Die Datenkrake, and ground plane stitching vias
    [OpenVizsla footprints.PcbLib, ov_ftdi.PcbDoc, ov_ftdi.PrjPcb, power.SchDoc, target USB interfaces v3.SchDoc]
2013-06-29 direct connect vias to polygons
    [ov_ftdi.PcbDoc]
2013-06-29 fix one last solder mask sliver error
    [ov_ftdi.PcbDoc]
2013-06-29 tweak some tracks
    [ov_ftdi.PcbDoc]
2013-06-29 add jtag labels
    [ov_ftdi.PcbDoc]
2013-06-29 label all the pins on silkscreen
    [ov_ftdi.PcbDoc]
2013-06-29 add backer logos to silkscreen layer (If these end up being too small for the silkscreen process, I'll go back and fix them after we see what they look like on the PCB.)
    [ov_ftdi.PcbDoc]
2013-06-29 LABEL ALL THE THINGS
    [ov_ftdi.PcbDoc]
2013-06-29 fix testpoint numbering
    [ov_ftdi.PcbDoc, target USB interfaces v3.SchDoc]
2013-06-29 add "afterthought" test points for the 3 unused FPGA pins
    [fpga.SchDoc, ov_ftdi.PcbDoc]
2013-06-29 add (optional) silkscreen on bottom layer
    [ov_ftdi.PcbDoc]
2013-06-30 fix hole size DRC error
    [ov_ftdi.PcbDoc]
2013-06-30 fix LED silkscreen width
    [OpenVizsla footprints.PcbLib, ov_ftdi.PcbDoc]
2013-06-30 fix inductor silkscreen overlap
    [OpenVizsla footprints.PcbLib, ov_ftdi.PcbDoc]
2013-06-30 board tweaking to address solder mask sliver issues
    [OpenVizsla footprints.PcbLib, ov_ftdi.PcbDoc]
2013-07-02 add some missing logos
    [ov_ftdi.PcbDoc]
2013-07-02 switch to 4-layer board per bunnie
    [ov_ftdi.PcbDoc]
2013-07-02 add fab notes, layer stackup
    [ov_ftdi.PcbDoc]
2013-07-02 change 0603 resistor and 0805 cap footprints to avoid DRC errors
    [FPGA power v3.SchDoc, OpenVizsla footprints.PcbLib, fpga.SchDoc, ov_ftdi.PcbDoc, power.SchDoc, target USB interfaces v3.SchDoc, usb.SchDoc]
2013-07-02 reorder some reference IDs for aesthetics, sorry :)
    [FPGA power v3.SchDoc, RAM v3.SchDoc, fpga.SchDoc, ov_ftdi.PcbDoc, power.SchDoc, target USB interfaces v3.SchDoc, usb.SchDoc]
2013-07-02 switch to 10K resistor for Rvbus, per USB3343 eval board
    [fpga.SchDoc, ov_ftdi.PcbDoc, target USB interfaces v3.SchDoc]
2013-07-02 change R4 to 2.2K to save a BOM item
    [ov_ftdi.PcbDoc, usb.SchDoc]
2013-07-02 tent all vias
    [ov_ftdi.PcbDoc]
2013-07-02 fix FarSite logo
    [ov_ftdi.PcbDoc]
2013-07-02 fix Altium logo
    [ov_ftdi.PcbDoc]
2013-07-02 fix MyDevice logo
    [ov_ftdi.PcbDoc]
2013-07-02 fix OPA logo
    [ov_ftdi.PcbDoc]
2013-07-03 remove superfluous 1.2v vias
    [ov_ftdi.PcbDoc]
2013-07-03 add USB taps to FPGA
    [fpga.SchDoc, ov_ftdi.PcbDoc, ov_ftdi.PrjPcb, target USB interfaces v3.SchDoc]
2013-07-04 consolidate power testpoints
    [ov_ftdi.PcbDoc, power.SchDoc, target USB interfaces v3.SchDoc, usb.SchDoc]
2013-07-04 tidy up vias
    [ov_ftdi.PcbDoc]
2013-07-05 retouch logo
    [ov_ftdi.PcbDoc]
2013-07-05 add BOM output
2013-07-06 clean up Camtastic DRC errors at the PrjPCB layer
    [FPGA power v3.SchDoc, fpga.SchDoc, ov_ftdi.PcbDoc, power.SchDoc, target USB interfaces v3.SchDoc, usb.SchDoc]
2013-07-06 add PCB layer legend, serial number blank
    [ov_ftdi.PcbDoc]
2013-07-06 shrink acrylic hole for button
    [OpenVizsla footprints.PcbLib, ov_ftdi.PcbDoc]
2013-07-09 proto1 pcbdoc
    [ov_ftdi.PcbDoc]
2013-07-09 add marcan's FTDI EEPROM init code (writes currently disabled)
2013-07-10 replace bitbang mode commands with MPSSE commands
    [fastftdi.c, fastftdi.h, fpgaconfig.c]
2013-07-14 add ZiruX logo
    [ov_ftdi.PcbDoc]
2013-07-14 add missing pullups
    [RAM v3.SchDoc, fpga.SchDoc, ov_ftdi.PcbDoc, ov_ftdi.PrjPcb, usb.SchDoc]
2013-07-14 add pin numbers and tick marks
    [ov_ftdi.PcbDoc]
2013-07-14 setup Altium's signal integrity modeling (not convinced yet that it's useful)
    [FPGA power v3.SchDoc, RAM v3.SchDoc, fpga.SchDoc, ov_ftdi.PcbDoc, ov_ftdi.PrjPcb, power.SchDoc, target USB interfaces v3.SchDoc, usb.SchDoc]
2013-07-14 add 33ohm series termination resistors to CCLK and CLKOUT
    [fpga.SchDoc, ov_ftdi.PcbDoc, usb.SchDoc]
2013-07-15 add some more silkscreen and call this OV v3.1
    [ov_ftdi.PcbDoc]
2013-07-26 simple bitstream to turn on LED1 and LED3
2013-07-28 fix JTAG routing
    [fpga.SchDoc, ov_ftdi.PcbDoc]
2013-07-28 fix spurious DRC errors, untented vias
    [ov_ftdi.PcbDoc]
2013-07-28 add polygon pour cutout for current measurement jumper (to avoid shorting to ground)
    [ov_ftdi.PcbDoc]
2013-07-28 fix inductor 2.2uH -> 4.7uH
    [ov_ftdi.PcbDoc, power.SchDoc]
2013-07-28 fix serial number silkscreen
    [ov_ftdi.PcbDoc]
2013-08-08 new USB VID/PID (thanks, OpenMoko!)
2013-08-18 Blink-a-led with migen/mibuild and OV3 platform definition.
2013-08-20 First shot at SDRAM controller (doesn't work properly yet)
    [clocking.py, top.py]
2013-08-25 Add ULPI (+Sim), not yet wired up
2013-08-30 Wire up ULPI in toplevel module
2013-09-05 software/host: add python bindings and python tool
    - python bindings for hw_init and fastftdi
    - python wrapper for pythonic interface
    - initial implementation of CSR ioread/iowrite
    [LibOV.py, ovctl.py]
2013-09-05 software/host: switch to .py tools
2013-09-05 fpga: add FTDI interface / cmdproc
    - parser / bus master / encoder for basic CSR io commands
    - interleaver for muxing streaming data with command completions
    - csr regs for leds/button
2013-09-06 software/fpga: LED multiplexing
    HW support for multiplexing LEDs from internal logic state
    Future use for trigger/status output, also for handy debug
2013-09-11 software/fpga: fix bus interleaver
    [bus_interleave.py]
2013-09-11 software/fpga: add FTDI TX/RX to LED mux
    - LED1/2 can now show FTDI TX/RX (respectively), MUX=2
2013-09-11 software/fpga: add LFSR-based random traffic generator
    - Traffic generator for FTDI burn-in / throughput testing
    [cmdproc.py, ftdi_lfsr_test.py, top.py]
2013-09-13 software/fpga/ulpi: Add SOP/EOP stuffing
    RXCMDs aren't necessarily generated at start-of-packet or
    end-of-packet. Stuff start-of-packet and end-of-packet
    indicators into the token stream by reusing RXCMD values
    that our configuration doesn't generate.
    [constants.py, ulpi.py]
2013-09-25 fix building on OS X
    [LibOV.py]
2013-09-25 better USB error handling
    [fpgaconfig.c, ovctl.py]
2013-10-21 add R24 1Mohm resistor to 26MHz xtal
    [ov_ftdi.PcbDoc, ov_ftdi.PrjPcb, target USB interfaces v3.SchDoc]
2013-10-21 connect ACBUS4 (SIWUA) to FPGA (TP15)
    [fpga.SchDoc, ov_ftdi.PcbDoc]
2013-10-21 space LEDs out, make LED1-3 red, yellow, green
    [fpga.SchDoc, ov_ftdi.PcbDoc]
2013-11-05 ovtl: add "speed" and "format" for "sniff"; add demo custom formatter LibOV: correctly calculate expected frame number based on speed.
    [LibOV.py, ovctl.py]
2013-11-06 experimental PCAP output and (very basic) wireshark dissector
2013-12-02 software/fpga/sdram: Replaced SDRAM controller, added BIST
    - FPGA hardware now supports onboard BIST
    - Added support for SDRAM BIST to ovctl
    (report and sdramtest commands)
    [ovctl.py, sdram_bist.py, sdrambistcfg.py, sdramctl.py, top.py]
2013-12-12 software/fpga: Fix BIST simulation
    [sdram_bist.py]
2013-12-13 software/fpga: Move/cleanup more tests
    - Move in-file ovhw tests to sim
    - Fix + rebuild tests so they work + for more error checking
    [bus_interleave.py, leds.py]
2013-12-16 add udev file to correct USB device node permissions (you need to copy this to /etc/udev/rules.d/)
2013-12-29 add trig coax connectors, misc PCB cleanup
    [OpenVizsla footprints.PcbLib, OpenVizsla symbols.SchLib, RAM v3.SchDoc, fpga.SchDoc, ov_ftdi.PcbDoc]
2014-01-09 move SMA connector outlines to Mech 11 from Mech 2 (which we're using for the plastic)
    [OpenVizsla footprints.PcbLib, ov_ftdi.PcbDoc]
2014-01-09 move R25 next to FPGA
    [ov_ftdi.PcbDoc]
2014-01-10 add migen logo solder mask color = BLUE
    [ov_ftdi.PcbDoc]
2014-01-12 Switch from 50MHz osc to 12MHz FTDI clock input
    This adds a DCM to double the clock to 24MHz first, since the PLL
    minimum input frequency is 19MHz.
2014-01-30 change FTDI tap resistor R3 to 100 ohms let's call this rc1
    [fpga.SchDoc]
2014-03-10 Fix bitgen warning about PSEN
    [clocking.py]
2014-03-20 fix missing +1.2v and +5v traces
    [ov_ftdi.PcbDoc]
2014-03-20 add ground cutout on top, inner 1, and ground under LM3670 switching pin (per datasheet)
    [ov_ftdi.PcbDoc]
2014-03-20 touch up silkscreen, label as v3.2
    [ov_ftdi.PcbDoc]
2014-03-22 fix missing bottom overlay in OutJob
    [ov_ftdi.PcbDoc]
2014-03-23 clean up +1.2v supply
    [ov_ftdi.PcbDoc, power.SchDoc]
2014-03-24 change 0.1uF caps to 0402 and vias to 14/24
    [FPGA power v3.SchDoc, RAM v3.SchDoc, fpga.SchDoc, ov_ftdi.PcbDoc, power.SchDoc, target USB interfaces v3.SchDoc, usb.SchDoc]
2014-03-24 rework decoupling network
    [ov_ftdi.PcbDoc]
2014-03-24 increase width of 5v traces
    [ov_ftdi.PcbDoc]
2014-03-24 rework +1.2v supply
    [ov_ftdi.PcbDoc]
2014-03-24 improve 3.3v supply
    [ov_ftdi.PcbDoc]
2014-03-26 clean up silkscreen a smidge
    [ov_ftdi.PcbDoc]
2014-03-26 cleanup silkscreen, schematics
    [FPGA power v3.SchDoc, OpenVizsla symbols.SchLib, RAM v3.SchDoc, fpga.SchDoc, ov_ftdi.PcbDoc, power.SchDoc, target USB interfaces v3.SchDoc, usb.SchDoc]
2014-03-26 add current sense resistor footprint
    [ov_ftdi.PcbDoc, target USB interfaces v3.SchDoc]
2014-03-26 add note about switch options
    [fpga.SchDoc]
2014-04-20 consolidate 2 schematic sheets into one to bring page count down to 5
    [RAM and target USB.SchDoc, RAM v3.SchDoc, ov_ftdi.PrjPcb, target USB interfaces v3.SchDoc]
2014-04-20 add license statement to schematics, ala bunnie's Novena project (Copyrights: CC-BY-SA 3.0 Patents: Apache 2.0)
    [FPGA power v3.SchDoc, RAM and target USB.SchDoc, fpga.SchDoc, power.SchDoc, usb.SchDoc]
2014-11-08 Fix non-working custom output format. The variable "speed" is not defined in this scope. Additionally output timestamp and flags.
    [ovctl.py]
2014-11-09 build.py,LibOV.py: Fix CSRs > 8bit
    [LibOV.py, build.py]
2014-11-09 ovhw/sdramctl.py: hack edge cases; when d_term is asserted during a re-issue, previously the i_stb was lost
    [sdramctl.py]
2014-11-09 sdram_sink.py: attempt to fix wrap around counter
    [sdram_sink.py]
2014-11-09 ovctl.py: de-configure SDRAM streaming, and use full SDRAM size
2015-01-22 Add detection of bad EEPROM settings.
    ovctl.py will now refuse to run (except the eeprom commands) if the
    EEPROM contents are not correct (at least the checksum and port modes,
    which are the bare minimum required). Also fix some other misc fail.
    [LibOV.py, ftdieep.c, ftdieep.h, ovctl.py]
2018-06-12 Initial update to current migen
    - Add misoc, fix import paths, use new names
    - Still incomplete: sim code, no hardware testing yet
    [build.py, bus_interleave.py, buttons.py, cfilt.py, clocking.py, cmdproc.py, csr_master.py]
2018-07-27 Fix two tests, fix bug exposed in CSR Busmaster code by new migen
    [cmdproc.py, csr_master.py, dummy_source.py]
2018-07-27 make it synth with current migen/misoc
2018-08-13 Propagate libusb error to upper layer
    Propagate error returned by libusb to upper layer to
    let user know that sth failed
    [ftdieep.c]
2018-08-16 Fix bitstream build process
    Since we moved from using build_cmdline() to build()
    we need to explicitly pass output dir and file name.
    Otherwise top.bit is being generated instead of ov3.bit
    [build.py]
2018-09-16 Avoid conflict with async keyword in Python versions >= 3.5.
    [LibOV.py, ovctl.py]
2019-01-17 fastftdi.c: Fix compiler warning about libusb_set_debug()
    fastftdi.c:94:3: warning: ‘libusb_set_debug’ is deprecated: Use libusb_set_option instead [-Wdeprecated-declarations]
    libusb_set_debug(dev->libusb, 2);
    [fastftdi.c]
2019-01-17 hardware: Add PDF rendering of schematics + component placement
2019-11-29 Add intercative bom to aid assembly (exported altium files to kicad and (#35)
    used https://github.com/openscopeproject/InteractiveHtmlBom to generate
2019-12-05 Remove obsolete wireshark dissector (#39)
    Update README.md to reflect the current Wireshark integration state.
2020-04-01 better self-explanatory --help output (#40)
    * ovctl.py: Improve description of subcommands in --help
    The --help output has always been rather sparse: The list of
    sub-commands was printed, but not related help / description given.
    Before this patch, the output of 'ovctl --help' looks like this:
    ----
    usage: ovctl.py [-h] [--pkg PKG] [-l] [--verbose] [--config-only]
    {uwrite,uread,report,sdramtest,sniff,debug-stream,ioread,iowrite,led-test,eep-erase,eep-program,sdram_host_read_test,lb-test}
    ...
    positional arguments:
    {uwrite,uread,report,sdramtest,sniff,debug-stream,ioread,iowrite,led-test,eep-erase,eep-program,sdram_host_read_test,lb-test}
    opti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
2021-03-12 Better gerbers (#44)
    * Remove sponsor logos from PCB
    * Improve output file formatting
    -Fix schematic formatting to work with AD20 (rectangle ordering issue)
    -Remove extraneous mechanical information from PCB
    -Remove extraneous mechanical layers from gerber output
    -Export individual layers to PDF
    -Add gerbers, drill, and pick-n-place outputs
    [Bill of Materials-ov_ftdi.csv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]
2021-03-12 Connect mounting holes to GND plane (#45)
    Addresses https://osmocom.org/issues/5066
    * Connect mounting holes to ground in schematic
    * Add PCB rule to connect mounting holes directly to ground plane, without thermals
    [FPGA power v3.SchDoc, ov_ftdi.PcbDoc, ov_ftdi.PrjPcb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]
2021-04-12 Osmocom updates for v3.3 production run (#46)
    * Move VBUS away from ground pad
    * Fixes: https://osmocom.org/issues/5070
    * Resize 3.3V polygon under U9, and redraw VBUS trace
    * Resize edge-launch SMA pads
    Addresses issue: https://osmocom.org/issues/5069
    * Reference pad size is: 1.75x3.125
    * Pads on design were 1x3.8, resized to 1.75x3.8 (keeping same length,
    but making wider).
    * 25% round corner added as well, to match reference design
    * different connection between USB shield and GND
    Addresses issue https://osmocom.org/issues/5071
    * Change shield-to-gorund topology of all USB connectors (J1, J2, J3) to
    a resistor/capacitor parallel connection
    * Increase size of shi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
    [Bill of Materials-ov_ftdi.csv, OpenVizsla symbols.SchLib, RAM and target USB.SchDoc, fpga.SchDoc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]
2021-05-31 Osmocom requested changes, second batch (#48)
    * Fix rotated labels in schematic
    Some schmatic properties were rotated, making it difficult to read them
    in the PDF.
    * Search for all rotated text using the query:
    ((ObjectKind = 'Parameter') or (ObjectKind = 'Comment')
    or (ObjectKind = 'Designator') or (ObjectKind = 'Net Label'))
    And (Orientation <> '0 Degrees')
    * Manually rotate and re-position.
    * Reduce soldermask opening around U3 pins
    Addresses: https://osmocom.org/issues/5109
    * Remove blanket soldermask opening under pins
    * Increase scope of previous soldermask design rule to include U3
    * Allow un-powered operation
    Addresses: https://osmocom.org/issues/5063
    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
    [Bill of Materials-ov_ftdi.csv, RAM and target USB.SchDoc, fpga.SchDoc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]
2021-05-31 remove hardware/ov_3.2_design.pdf (#50)
    The updated schematics, Gerbers, etc. are kept in
    the "hardware/Project\ Outputs\ for\ ov_ftdi/" and it is
    confusing if there is another PDF fixed to v3.2 somewhere else in
    the path.
    Users can always go back in commit history to obtain the older
    versions, but master should not contain renderings of old versions.
